NortheastDesigns/Venturi-MK8/IMPORTANT Turnaround differences.jpg

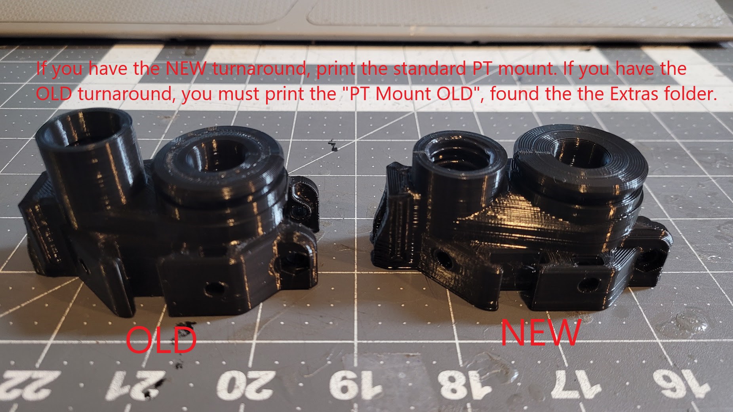
IMPORTANT Turnaround differences.jpg
