NortheastDesigns/Venturi-MK8/Frame Kit Package Contents.pdf

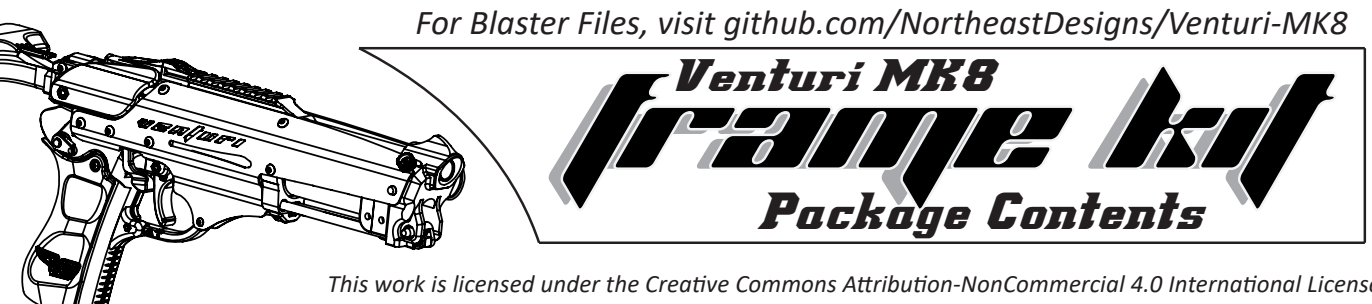
[picture p2: figure]
Venturi MK8; Package Contents; For Blaster Files, visit github.com/NortheastDesigns/Venturi-MK8 Frame kit frame kit

This work is licensed under the Creative Commons Attribution-NonCommercial 4.0 International License. To view a copy of this license, visit http://creativecommons.org/licenses/by-nc/4.0/

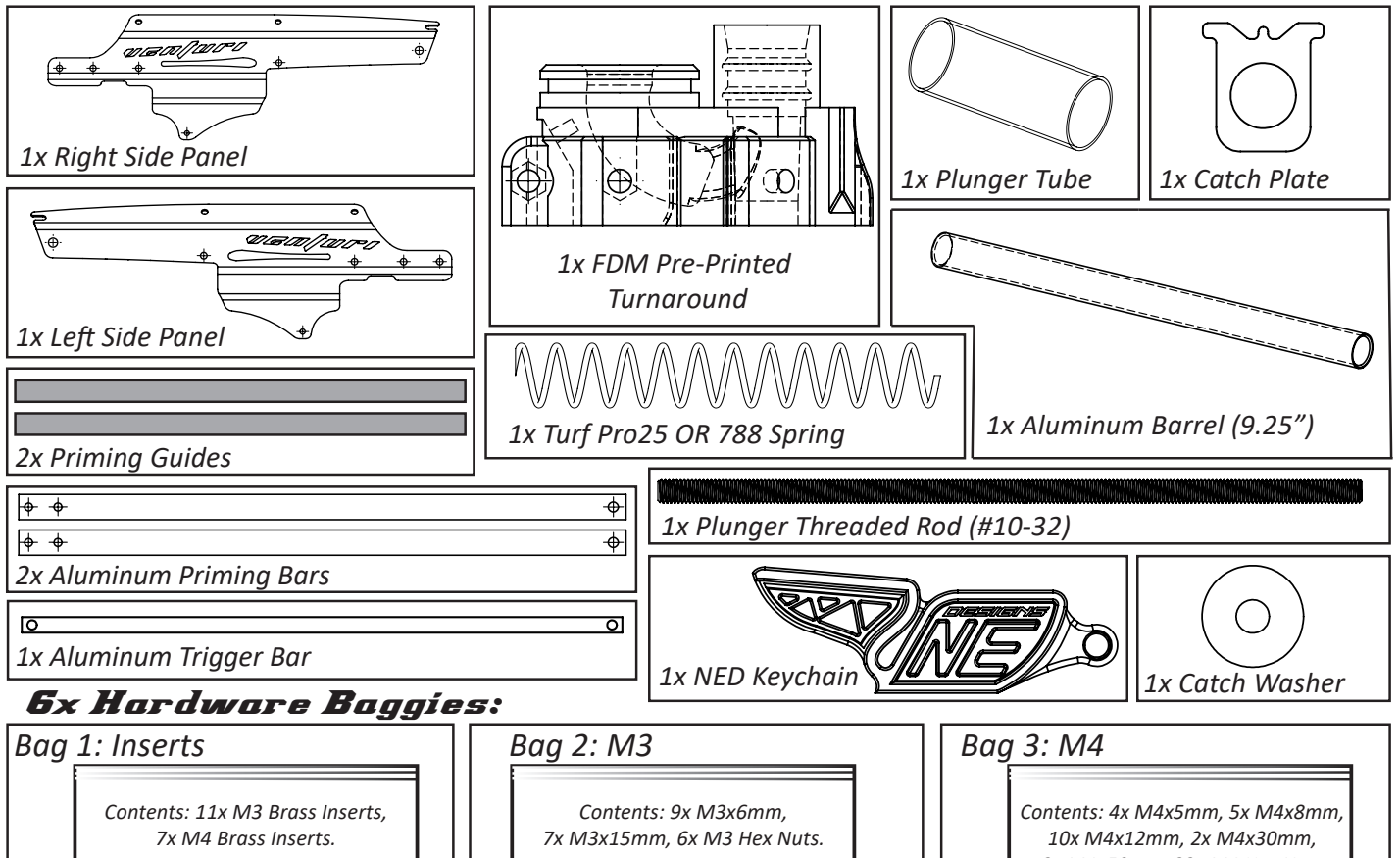
[picture p3: figure]
6x Hardware Baggies:; Lorem ipsum; 1x Aluminum Barrel (9.25”); 1x Plunger Tube; 1x Catch Plate; 1x FDM Pre-Printed Turnaround; 1x Turf Pro25 OR 788 Spring; 1x Plunger Threaded Rod (#10-32); 1x Right Side Panel; 1x Left Side Panel; Bag 1: Inserts; Bag 2: M3; Bag 3: M4; 2x Priming Guides; 2x Aluminum Priming Bars; Contents: 9x M3x6mm, 7x M3x15mm, 6x M3 Hex Nuts.; Contents: 4x M4x5mm, 5x M4x8mm, 10x M4x12mm, 2x M4x30mm,; Contents: 11x M3 Brass Inserts, 7x M4 Brass Inserts.; 1x NED Keychain; 1x Catch Washer; 1x Aluminum Trigger Bar

Bag 4: M5 | Bag 5: O Rings | Bag 6: Other 2x M4x50mm, 22x M4 Hex Nuts.

Contents: 3x M5x55mm,
2x M5 Hex Nuts.

Contents: 1x 123 Buna X ring, 1x 123 Buna O ring, 3x 202 Buna O rings.

Contents: 2 x 10-32 Acorn Nut, 3x Small Springs, 1x Body detent pin, 1x Actuator Detent Pin.

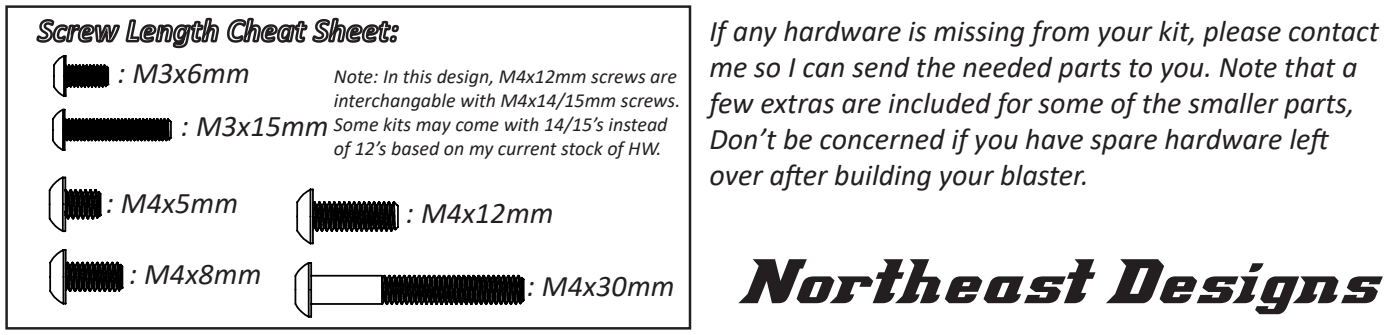
[picture p4: figure]
Northeast Designs; interchangable with M4x14/15mm screws. Some kits may come with 14/15’s instead; over after building your blaster.

Note: In this design, M4x12mm screws are

of 12’s based on my current stock of HW.

If any hardware is missing from your kit, please contact me so I can send the needed parts to you. Note that a few extras are included for some of the smaller parts, Don’t be concerned if you have spare hardware left
