NortheastDesigns/Venturi-MK8/Group A/Group A Orientations.PNG

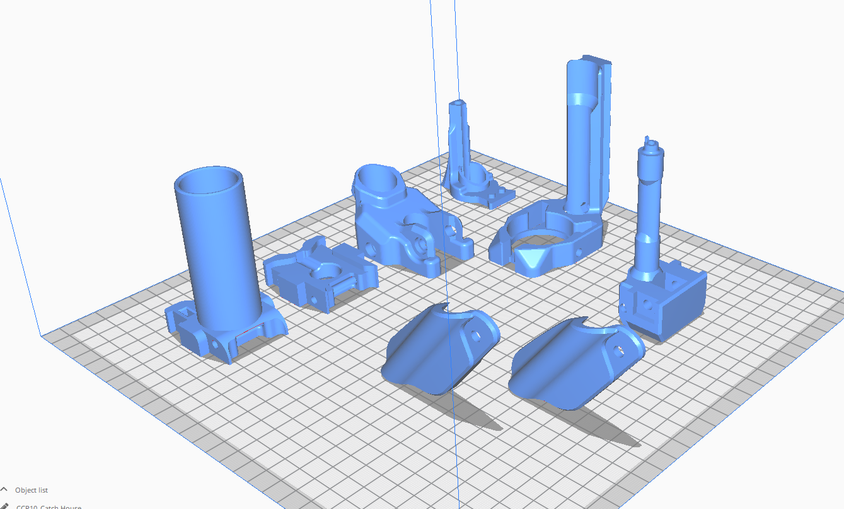
Group A/Group A Orientations.PNG
