NortheastDesigns/Venturi-MK8/Group B/Group B Orientations.PNG

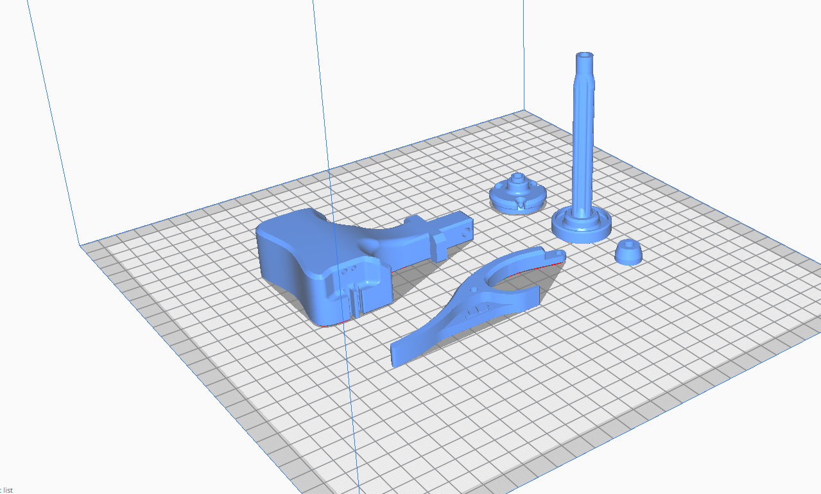
Group B/Group B Orientations.PNG
