NortheastDesigns/Venturi-MK8/Group C/Group C Orientations.PNG

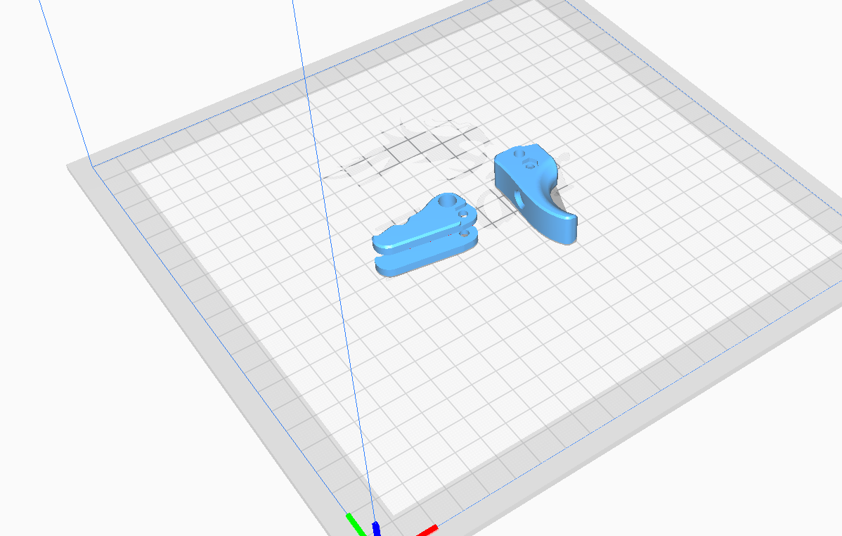
Group C/Group C Orientations.PNG
