NortheastDesigns/Venturi-MK8/Group D/Group D Orientations.PNG

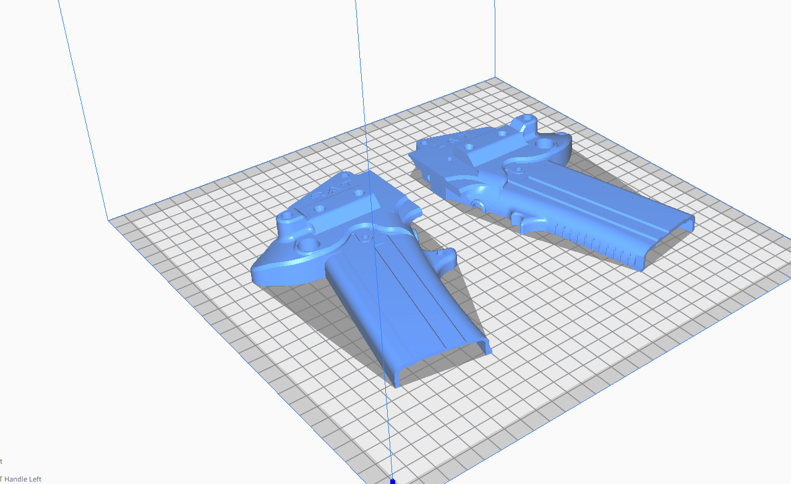
Group D/Group D Orientations.PNG
