NortheastDesigns/Venturi-MK8/Group E/Group E Orientations.PNG

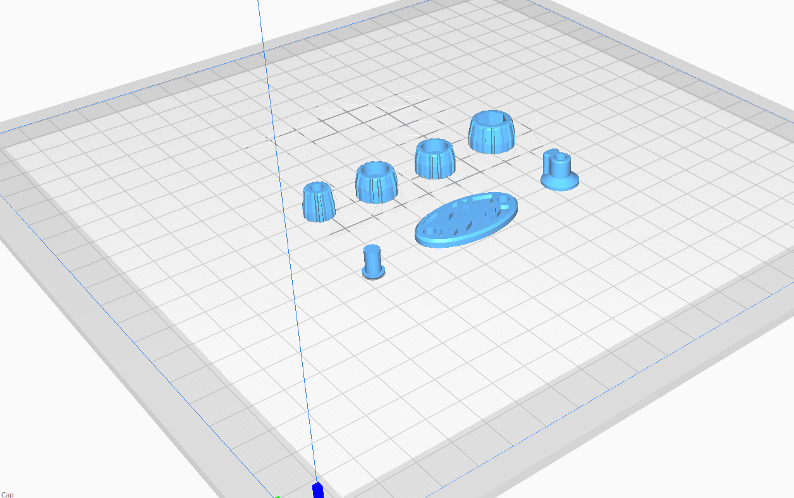
Group E/Group E Orientations.PNG
