NortheastDesigns/Venturi-MK8/Group F/Group F Orientation.PNG

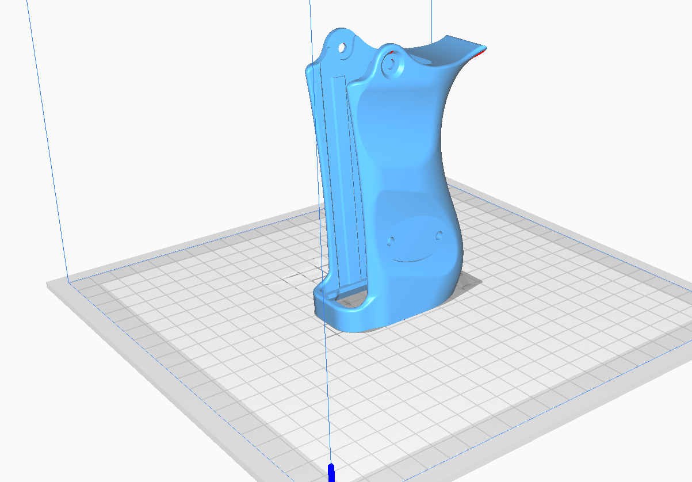
Group F/Group F Orientation.PNG
