NortheastDesigns/Venturi-MK8/Carbine/Finish Plate 1 Carbine.STL

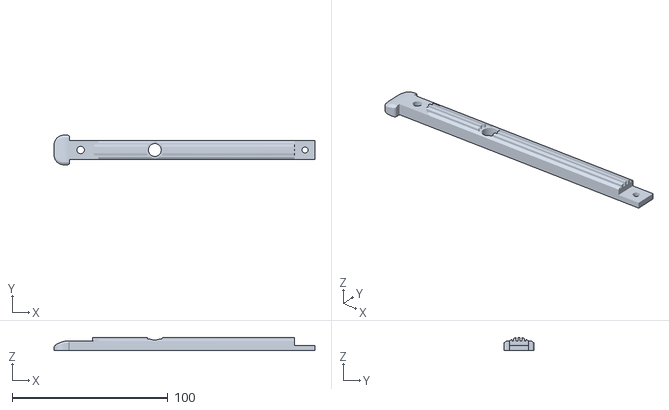
[picture p11: CAD file, 2021-06-01]
Carbine/Finish Plate 1 Carbine.STL
167.6 x 19.1 x 8.57
