NortheastDesigns/Venturi-MK8/Extras and Experimental/Mini T Pull.STL

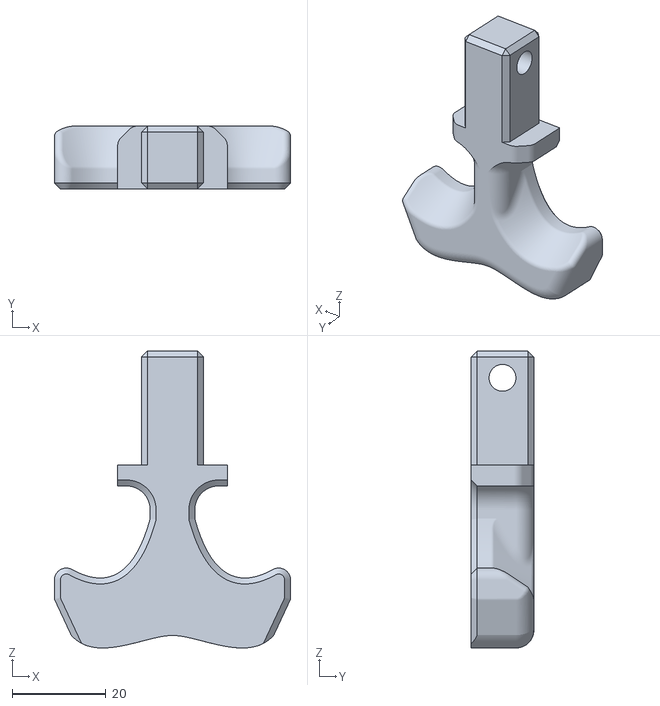
[picture p12: CAD file, 2022-07-08]
Extras and Experimental/Mini T Pull.STL
50.3 x 13.4 x 63.2
