NortheastDesigns/Venturi-MK8/Group A/Pusher.STL

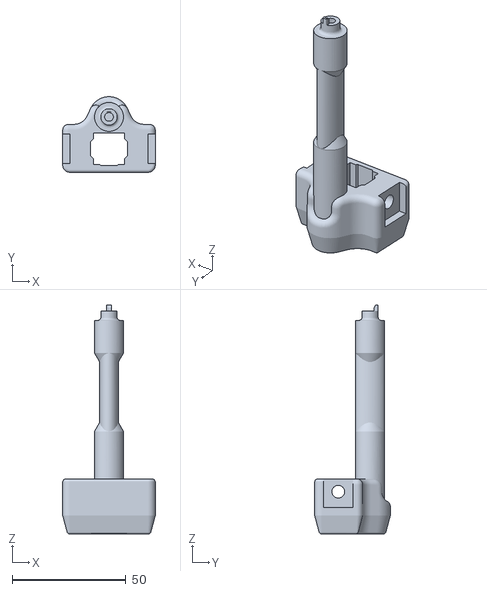
[picture p13: CAD file, 2022-07-08]
Group A/Pusher.STL
40.6 x 33.2 x 100.5
