NortheastDesigns/Venturi-MK8/Group B/T Pull.STL

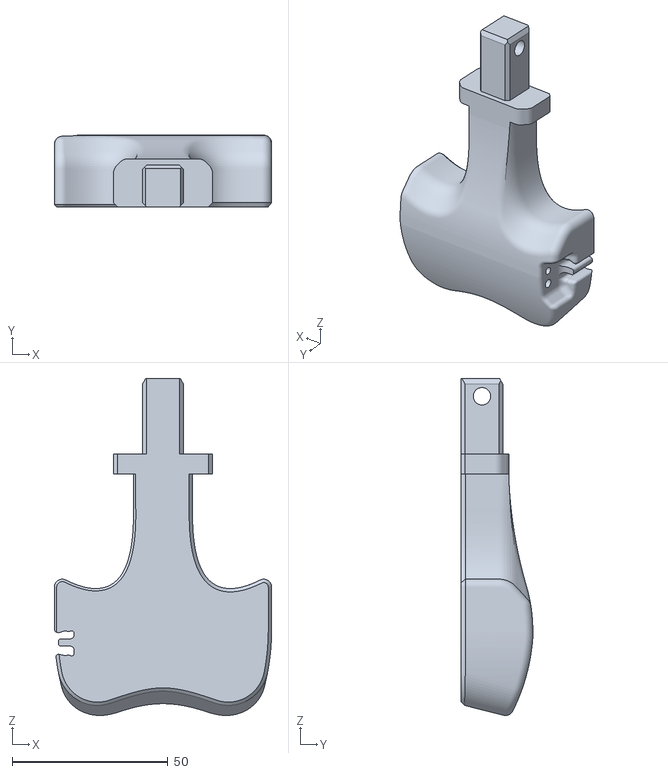
[picture p14: CAD file, 2022-07-08]
Group B/T Pull.STL
69.8 x 23.0 x 108.3
