NortheastDesigns/Venturi-MK8/Group C/Alternate Actuators/Actuator +.0125.STL

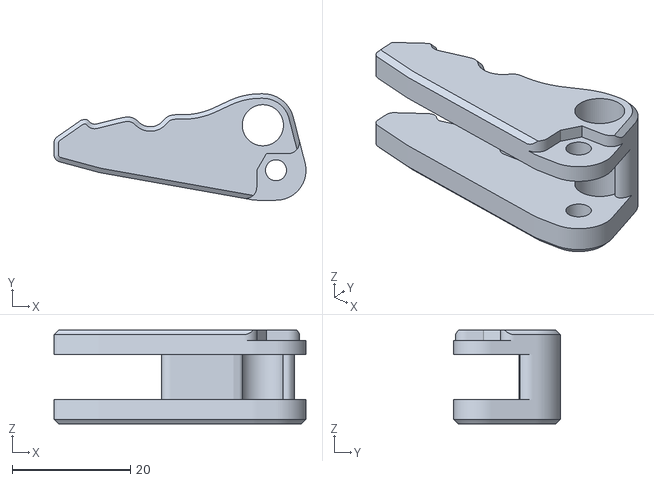
[picture p15: CAD file, 2021-04-18]
Group C/Alternate Actuators/Actuator +.0125.STL
42.7 x 18.0 x 15.9
