NortheastDesigns/Venturi-MK8/Group C/Trigger.STL

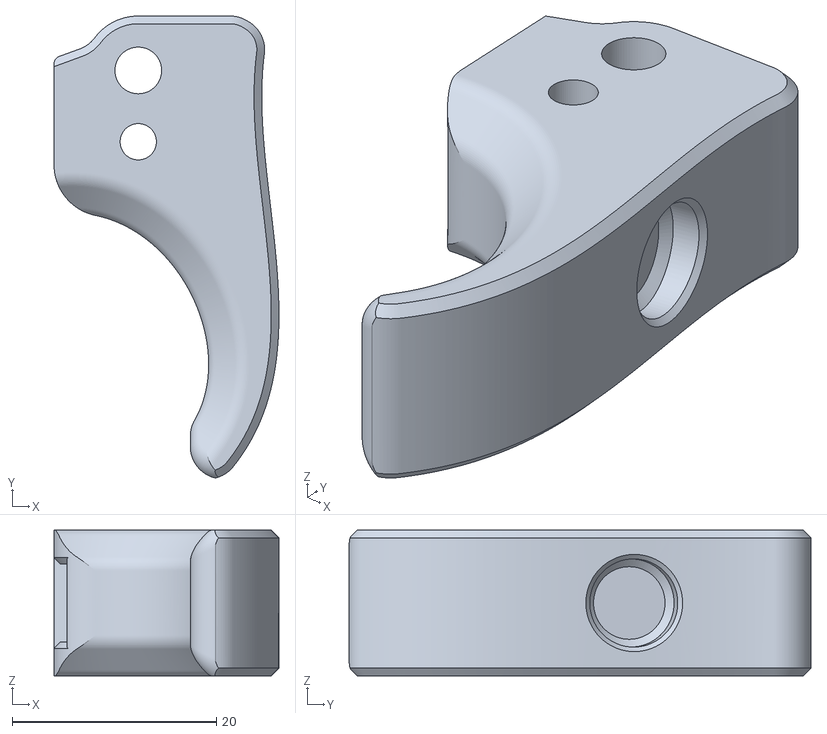
[picture p16: CAD file, 2021-08-10]
Group C/Trigger.STL
22.0 x 45.3 x 14.3
