NortheastDesigns/Venturi-MK8/Group D/ST Handle Right.STL

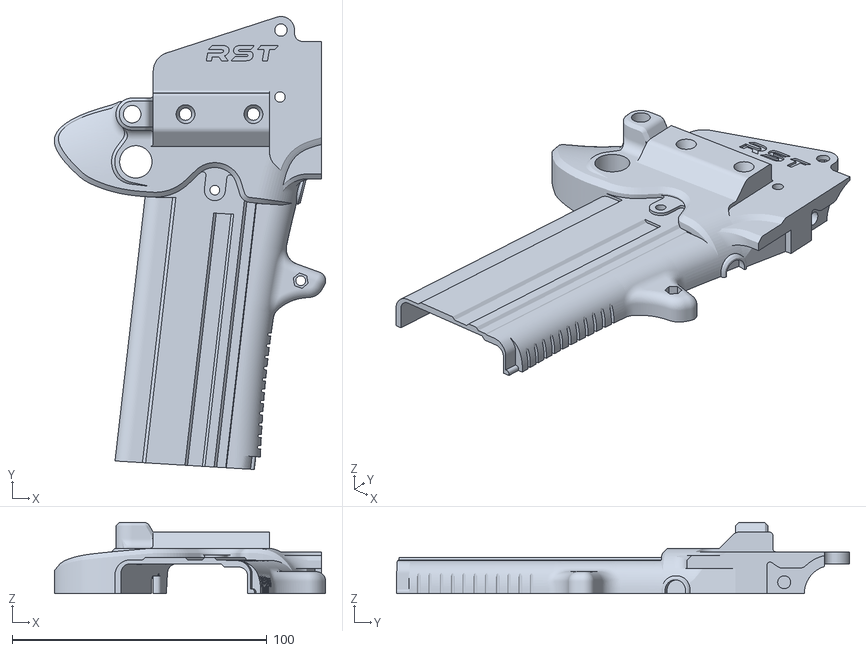
[picture p17: CAD file, 2021-05-18]
Group D/ST Handle Right.STL
106.6 x 177.9 x 27.9
