NortheastDesigns/Venturi-MK8/NO INSERTS/NO INSERTS ST Handle Left.STL

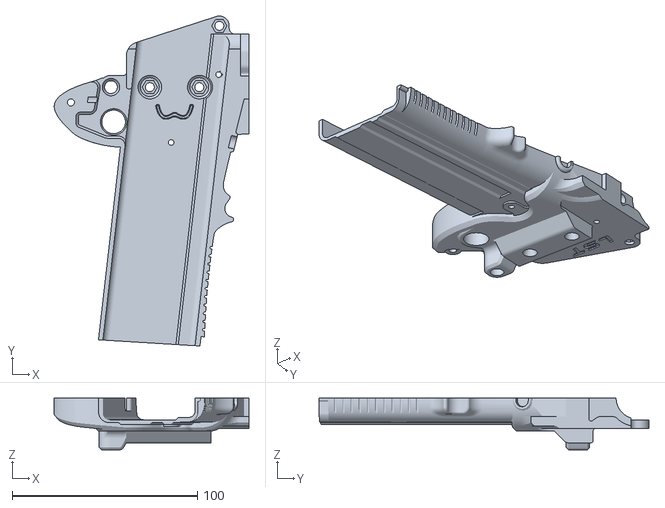
[picture p18: CAD file, 2021-04-18]
NO INSERTS/NO INSERTS ST Handle Left.STL
104.9 x 177.9 x 27.9
