NortheastDesigns/Venturi-MK8/Slim AT Handle/NO BOTTOM SHIM SLIM AT Handle Left.STL

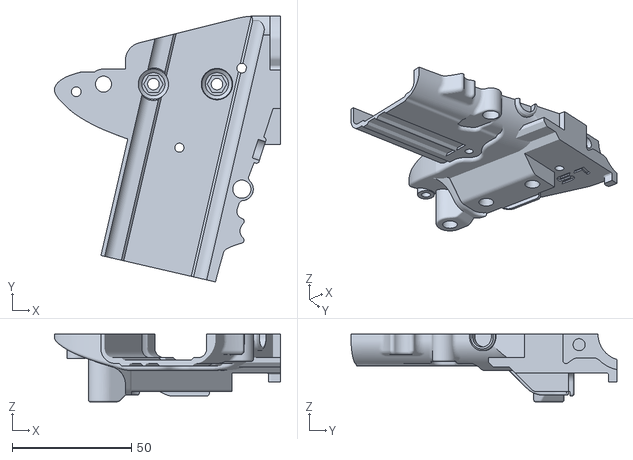
[picture p19: CAD file, 2022-07-27]
Slim AT Handle/NO BOTTOM SHIM SLIM AT Handle Left.STL
94.9 x 111.6 x 28.4
