NortheastDesigns/Venturi-MK8/Slimnose/Alternate Actuators/Slimnose Actuator +.025.STL

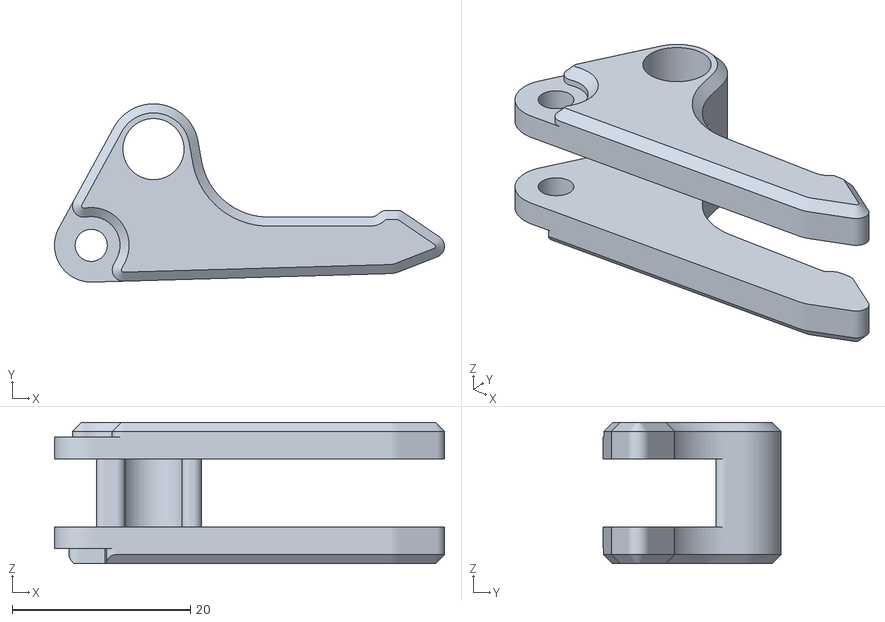
[picture p20: CAD file, 2022-07-08]
Slimnose/Alternate Actuators/Slimnose Actuator +.025.STL
43.8 x 20.0 x 15.9
