NortheastDesigns/Venturi-MK8/vertGrip_v2/vertGrip_rear_v2.stl

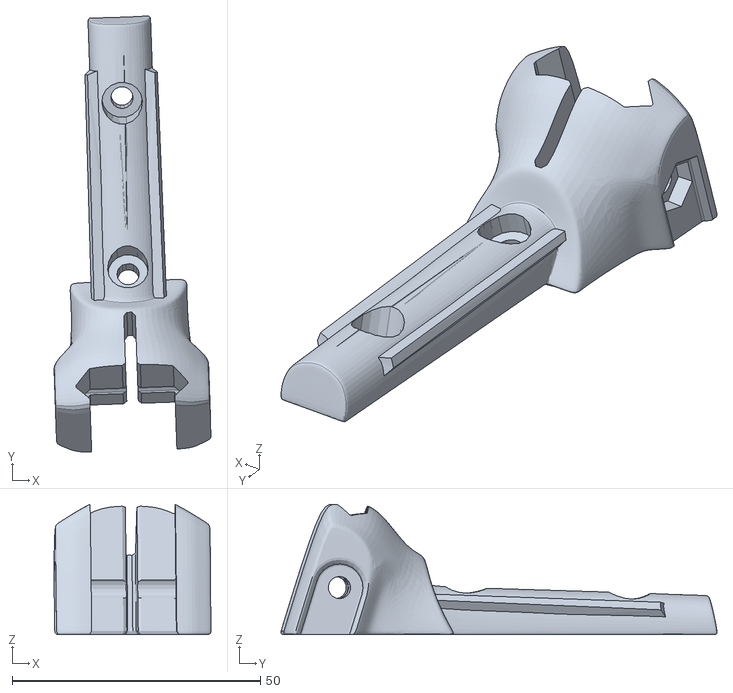
[picture p21: CAD file, 2022-07-27]
vertGrip_v2/vertGrip_rear_v2.stl
31.6 x 87.8 x 26.2
