NortheastDesigns/Venturi-MK8/Carbine/Finish Plate 2 Carbine.STL

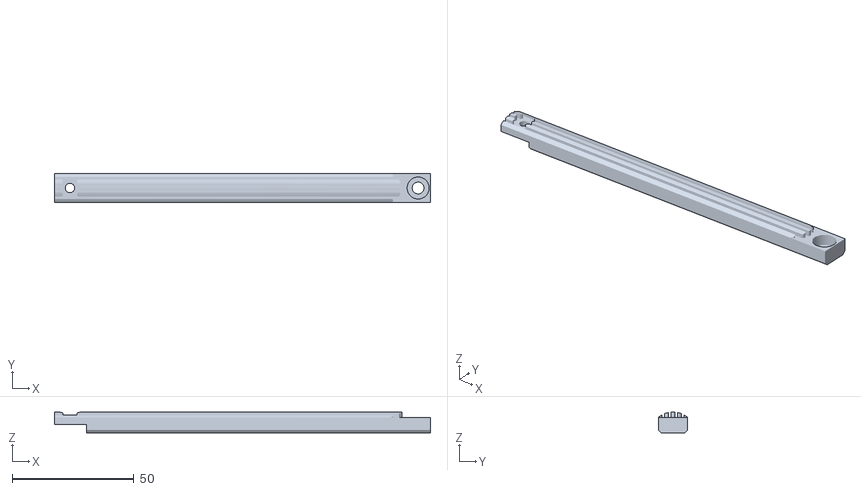
[picture p22: CAD file, 2021-06-01]
Carbine/Finish Plate 2 Carbine.STL
154.2 x 12.1 x 8.57
