NortheastDesigns/Venturi-MK8/Extras and Experimental/Pusher Adjustable Seal.STL

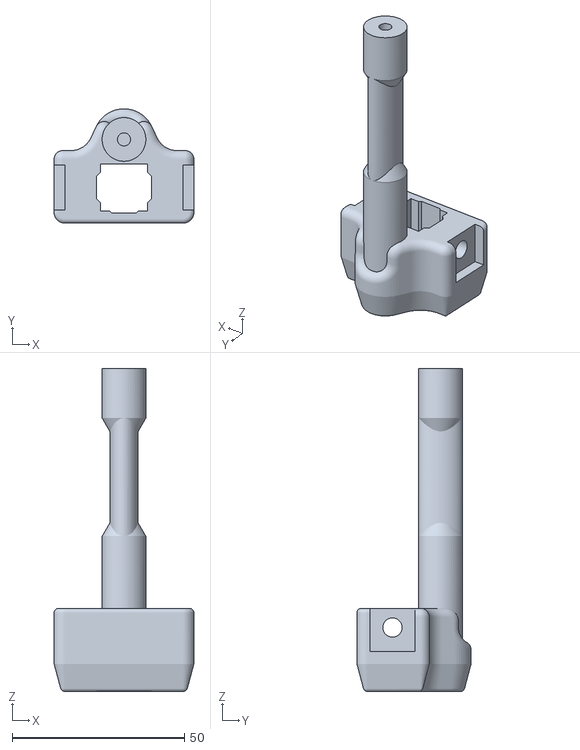
[picture p23: CAD file, 2022-07-08]
Extras and Experimental/Pusher Adjustable Seal.STL
40.6 x 33.2 x 93.8
