NortheastDesigns/Venturi-MK8/Group A/R Slide.STL

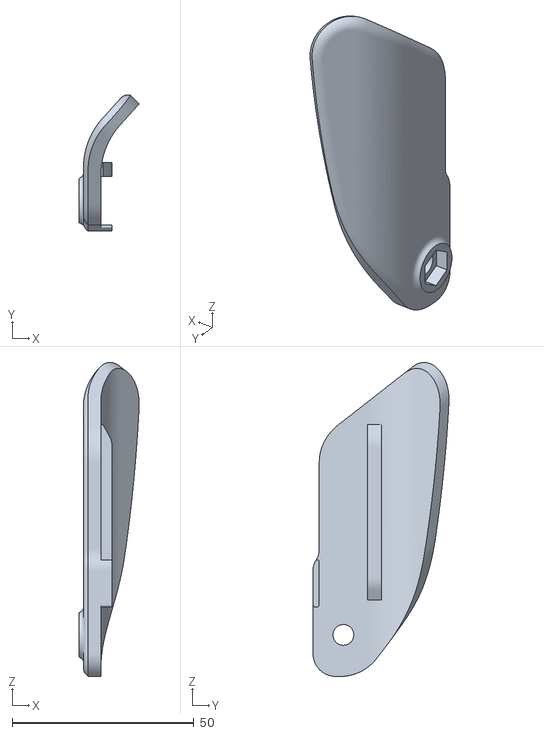
[picture p24: CAD file, 2022-07-08]
Group A/R Slide.STL
16.6 x 37.4 x 86.3
