NortheastDesigns/Venturi-MK8/Group B/HIGH ENGAGEMENT Plunger.STL

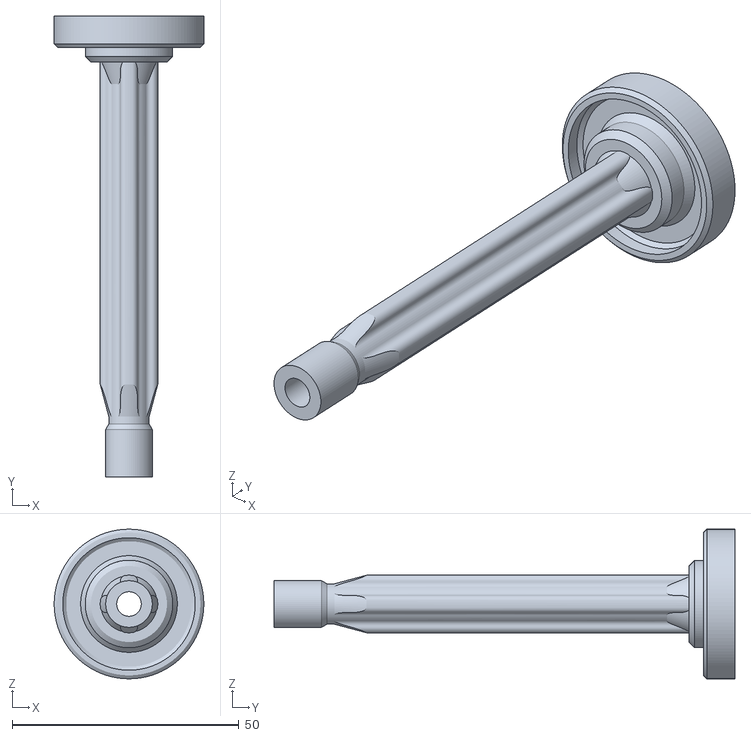
[picture p25: CAD file, 2022-07-08]
Group B/HIGH ENGAGEMENT Plunger.STL
33.0 x 101.7 x 33.0
