NortheastDesigns/Venturi-MK8/Group C/Actuator.STL

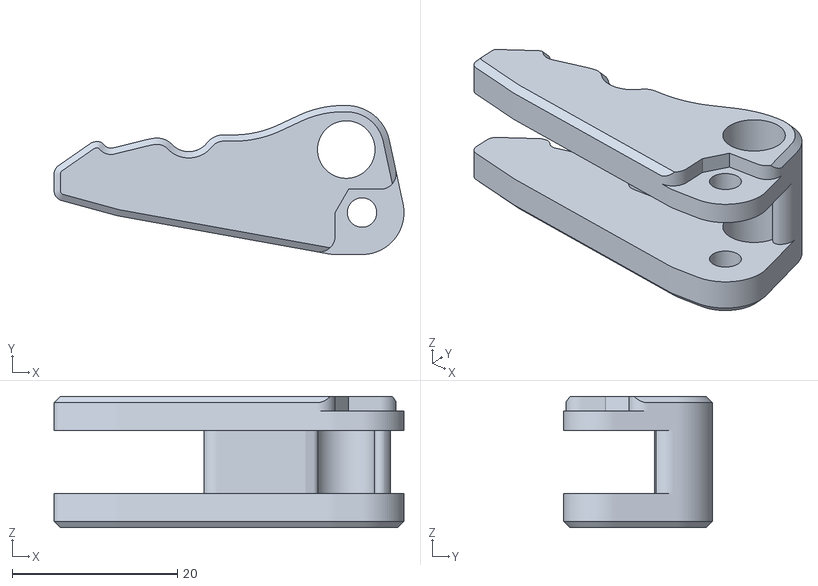
[picture p26: CAD file, 2021-04-18]
Group C/Actuator.STL
42.3 x 18.0 x 15.9
