NortheastDesigns/Venturi-MK8/Group C/Alternate Actuators/Actuator +.0625.STL

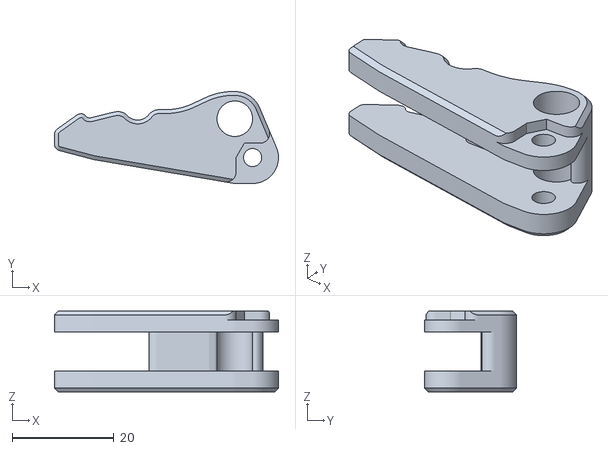
[picture p27: CAD file, 2021-04-18]
Group C/Alternate Actuators/Actuator +.0625.STL
43.9 x 18.0 x 15.9
