NortheastDesigns/Venturi-MK8/Slim AT Handle/SLIM AT Handle Right.STL

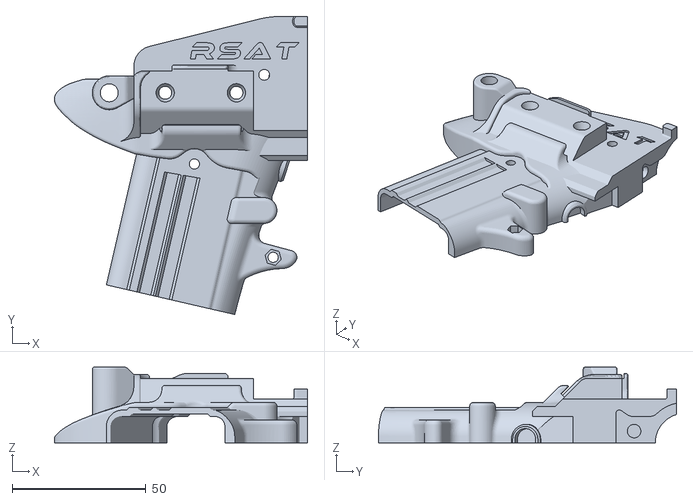
[picture p28: CAD file, 2022-07-27]
Slim AT Handle/SLIM AT Handle Right.STL
94.9 x 111.6 x 28.4
