NortheastDesigns/Venturi-MK8/Slimnose/Slimnose Muzzle.STL

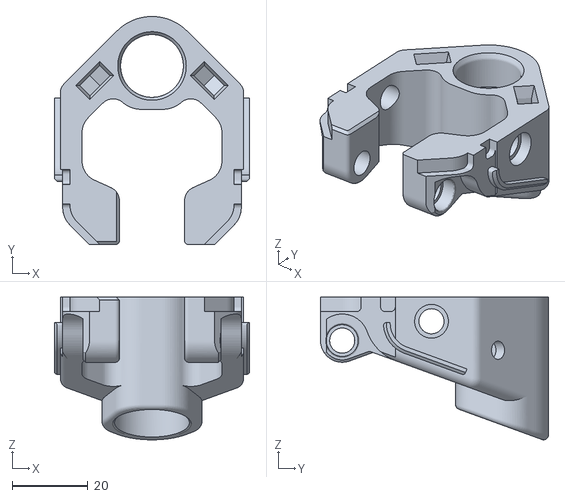
[picture p29: CAD file, 2022-07-08]
Slimnose/Slimnose Muzzle.STL
51.4 x 60.0 x 37.6
