NortheastDesigns/Venturi-MK8/Carbine/Pump Mount.STL

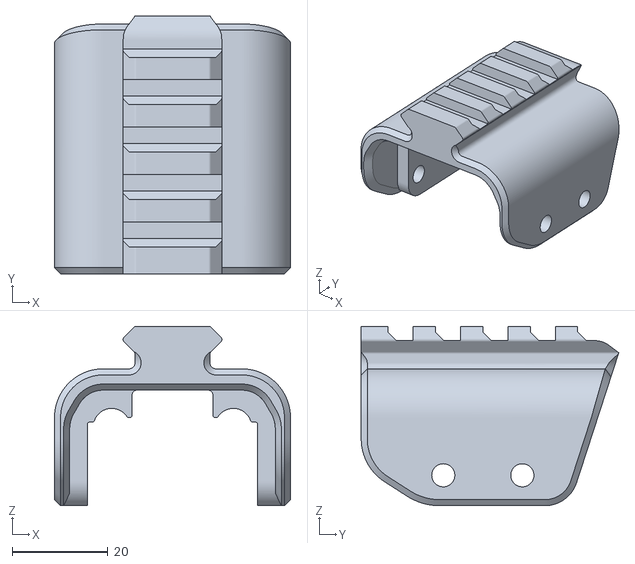
[picture p30: CAD file, 2021-06-01]
Carbine/Pump Mount.STL
49.3 x 53.8 x 37.5
