NortheastDesigns/Venturi-MK8/Extras and Experimental/Pusher Seat Min.STL

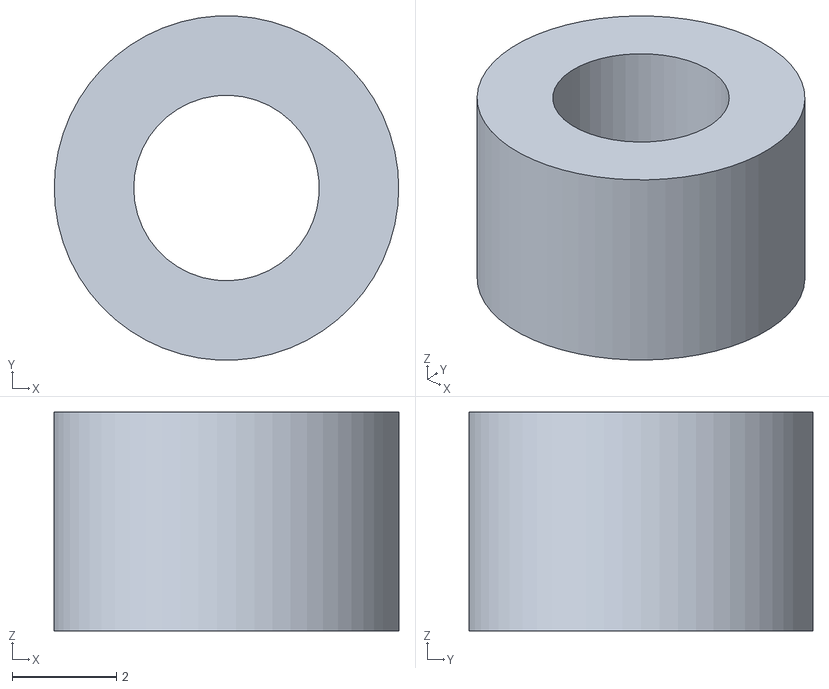
[picture p31: CAD file, 2022-07-08]
Extras and Experimental/Pusher Seat Min.STL
6.60 x 6.59 x 4.19
