NortheastDesigns/Venturi-MK8/Group A/L Slide.STL

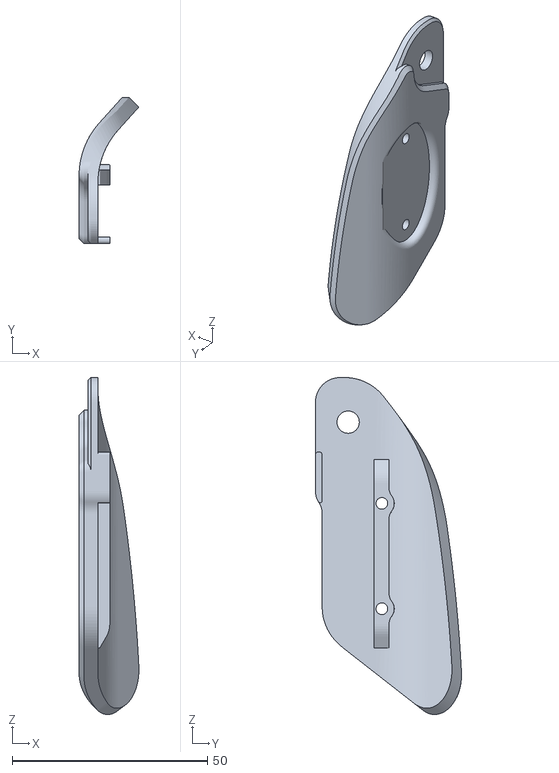
[picture p32: CAD file, 2022-07-08]
Group A/L Slide.STL
15.3 x 37.4 x 86.3
