NortheastDesigns/Venturi-MK8/Group B/LOW ENGAGEMENT Plunger.STL

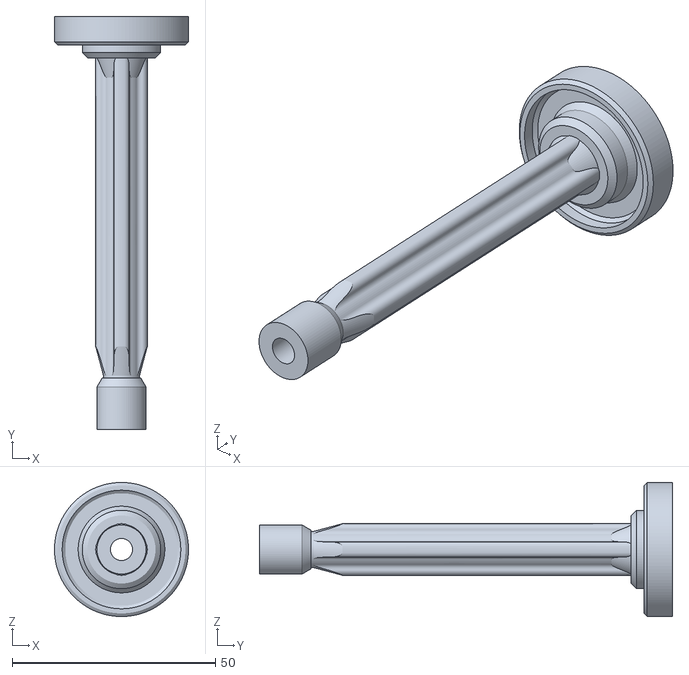
[picture p33: CAD file, 2022-07-08]
Group B/LOW ENGAGEMENT Plunger.STL
33.0 x 101.7 x 33.0
