NortheastDesigns/Venturi-MK8/Group C/Alternate Actuators/Actuator +.0375.STL

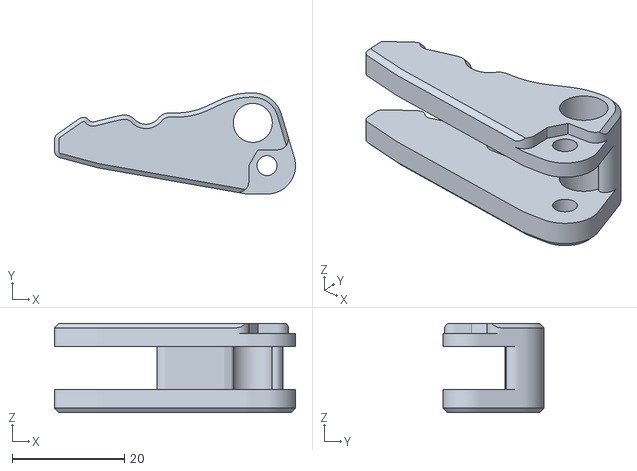
[picture p34: CAD file, 2021-04-18]
Group C/Alternate Actuators/Actuator +.0375.STL
43.0 x 18.0 x 15.9
