NortheastDesigns/Venturi-MK8/NO INSERTS/NO INSERTS Pusher.STL

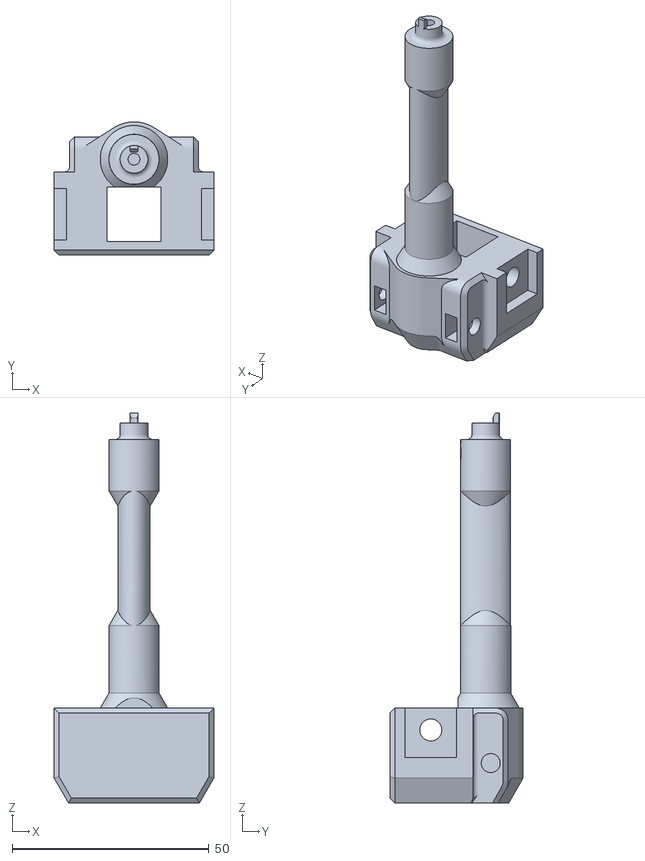
[picture p35: CAD file, 2021-04-18]
NO INSERTS/NO INSERTS Pusher.STL
40.6 x 33.9 x 99.2
