NortheastDesigns/Venturi-MK8/Slimnose/Slimnose Foregrip.STL

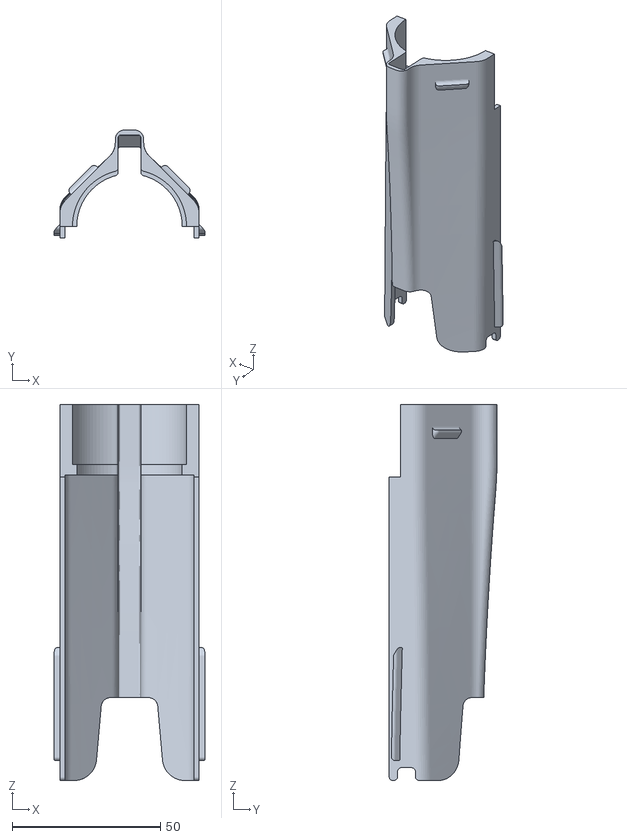
[picture p36: CAD file, 2022-07-08]
Slimnose/Slimnose Foregrip.STL
50.8 x 36.5 x 126.7
