NortheastDesigns/Venturi-MK8/Carbine/Pivot Bushing Carbine.STL

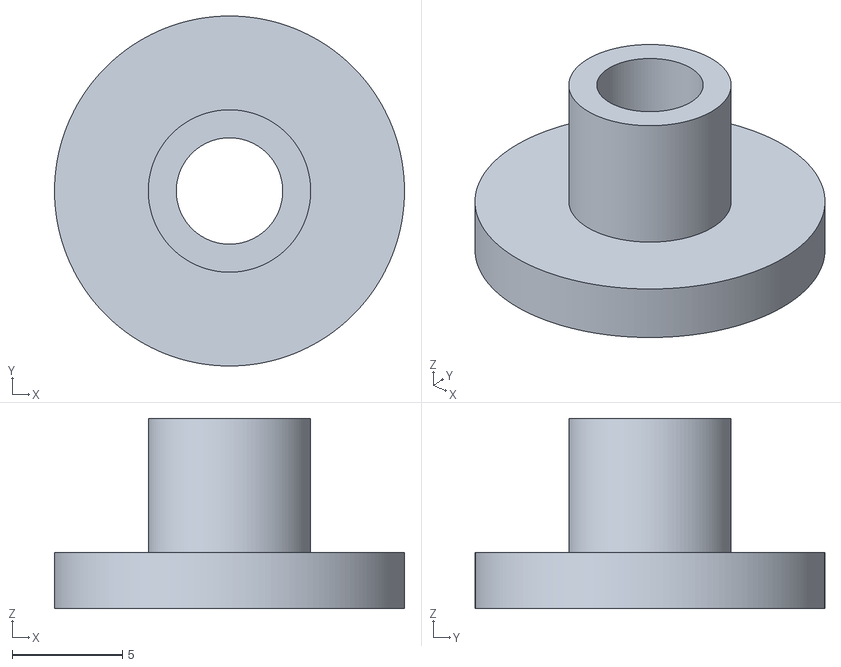
[picture p37: CAD file, 2021-05-07]
Carbine/Pivot Bushing Carbine.STL
15.9 x 15.9 x 8.64
