NortheastDesigns/Venturi-MK8/Extras and Experimental/Pusher Seat Mid.STL

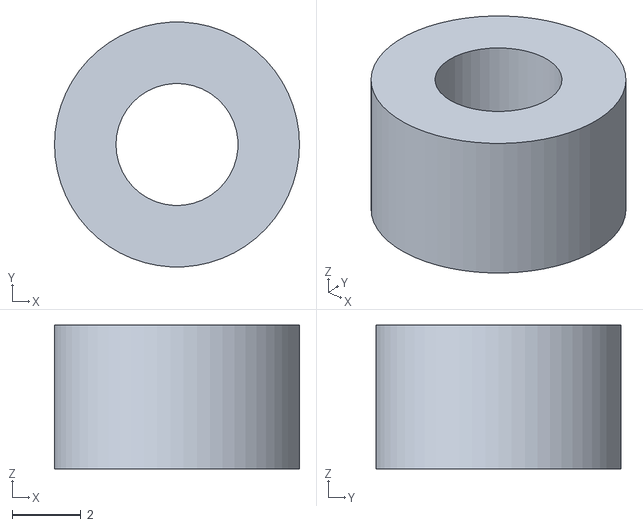
[picture p38: CAD file, 2022-07-08]
Extras and Experimental/Pusher Seat Mid.STL
7.14 x 7.13 x 4.19
