NortheastDesigns/Venturi-MK8/Group A/Muzzle.STL

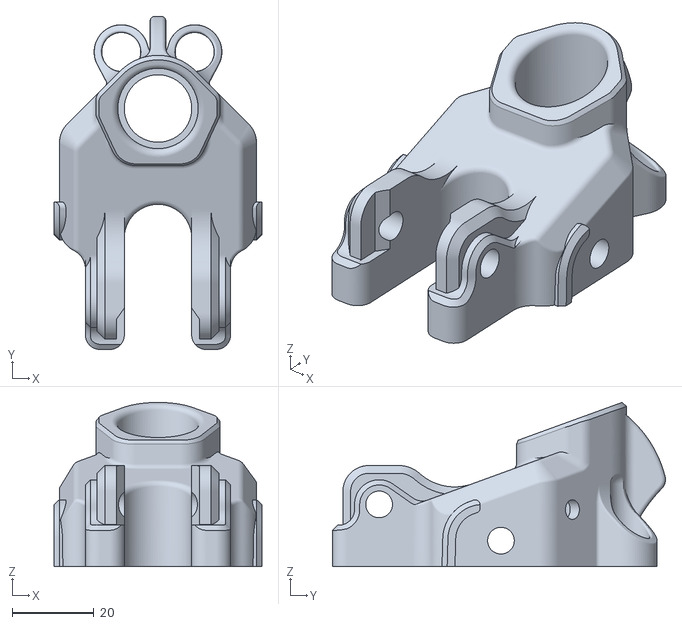
[picture p39: CAD file, 2021-08-10]
Group A/Muzzle.STL
50.9 x 81.6 x 40.2
