NortheastDesigns/Venturi-MK8/Group B/Catch Surface.STL

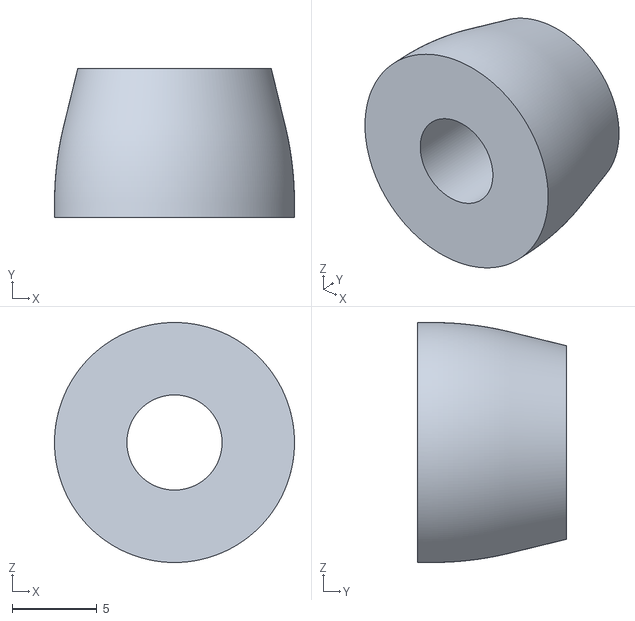
[picture p40: CAD file, 2021-05-18]
Group B/Catch Surface.STL
14.2 x 8.76 x 14.2
