NortheastDesigns/Venturi-MK8/Group E/Pusher Top.STL

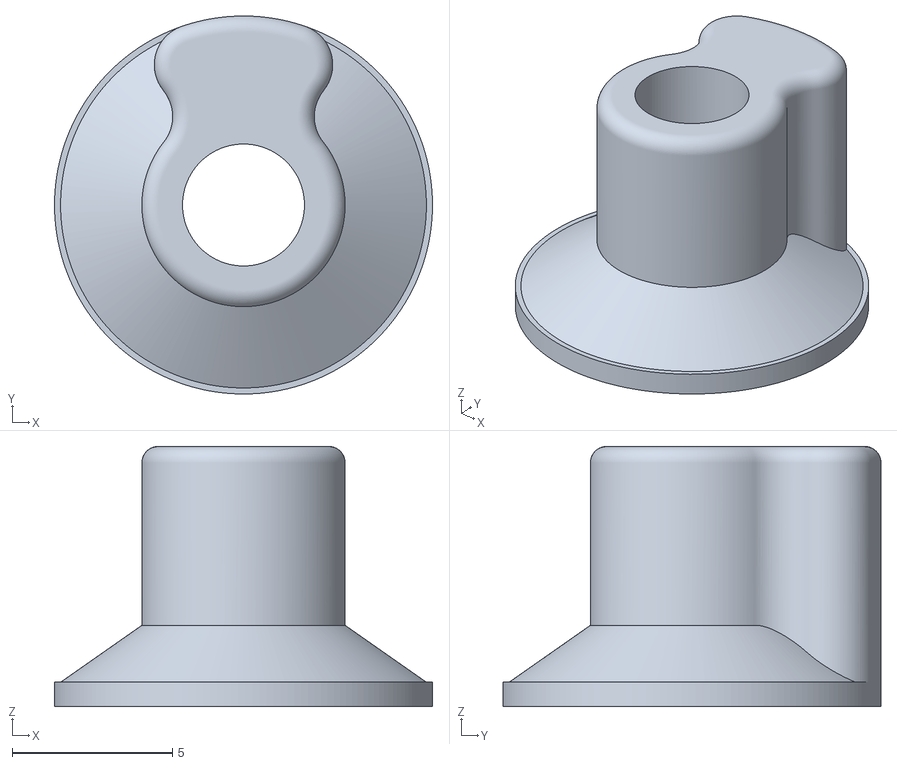
[picture p41: CAD file, 2021-06-01]
Group E/Pusher Top.STL
11.8 x 11.8 x 8.13
