NortheastDesigns/Venturi-MK8/Slimnose/Slimnose PT Mount.STL

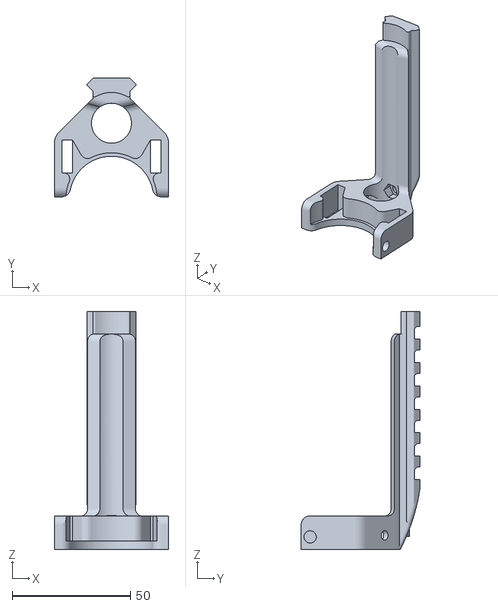
[picture p42: CAD file, 2022-07-08]
Slimnose/Slimnose PT Mount.STL
48.3 x 50.2 x 100.6
