NortheastDesigns/Venturi-MK8/Carbine/Butt Plate Carbine.STL

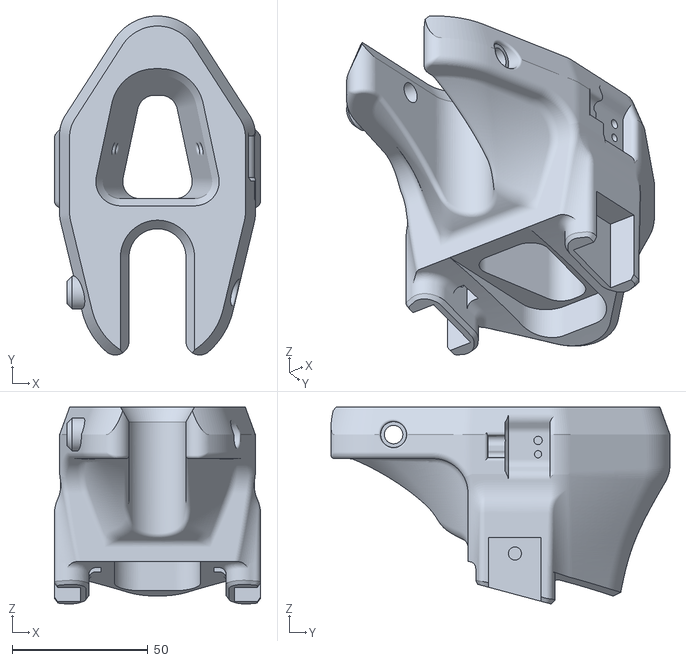
[picture p43: CAD file, 2021-05-07]
Carbine/Butt Plate Carbine.STL
75.9 x 124.9 x 72.6
