NortheastDesigns/Venturi-MK8/Extras and Experimental/Pusher Seat Max.STL

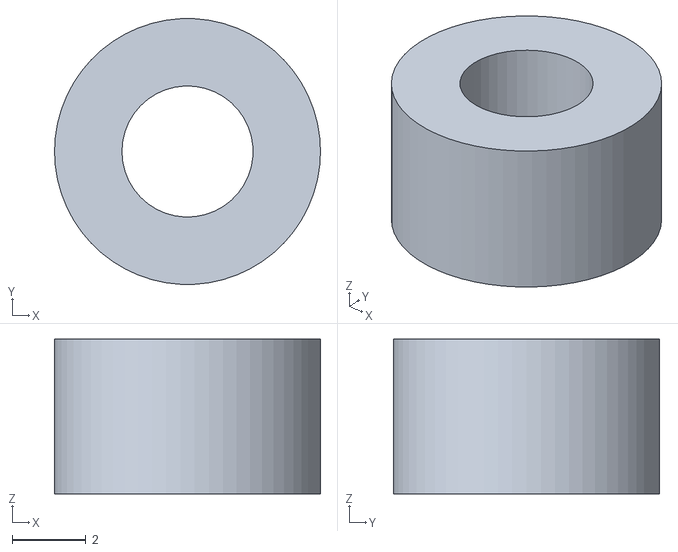
[picture p44: CAD file, 2022-07-08]
Extras and Experimental/Pusher Seat Max.STL
7.21 x 7.20 x 4.19
