NortheastDesigns/Venturi-MK8/Group A/Catch Roof.STL

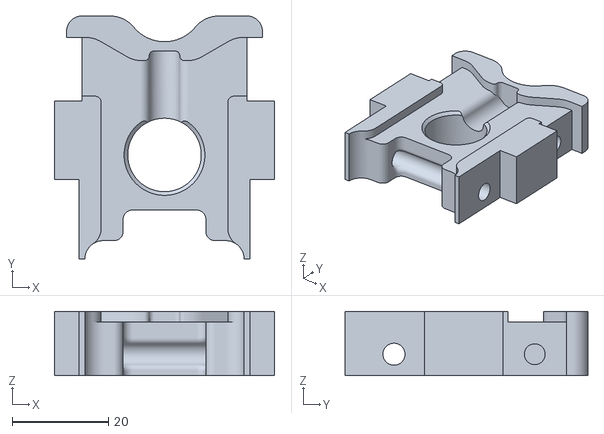
[picture p45: CAD file, 2021-08-10]
Group A/Catch Roof.STL
45.7 x 50.4 x 13.3
