NortheastDesigns/Venturi-MK8/Group B/ST T Gaurd.STL

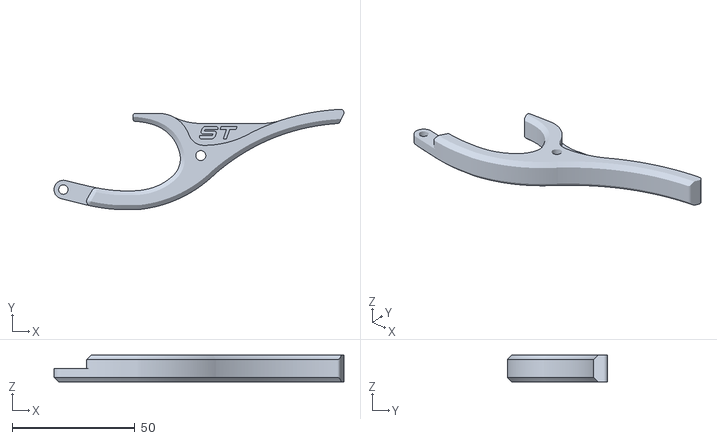
[picture p46: CAD file, 2021-05-18]
Group B/ST T Gaurd.STL
117.9 x 40.7 x 10.9
