NortheastDesigns/Venturi-MK8/NO INSERTS/NO INSERTS AT T Gaurd.STL

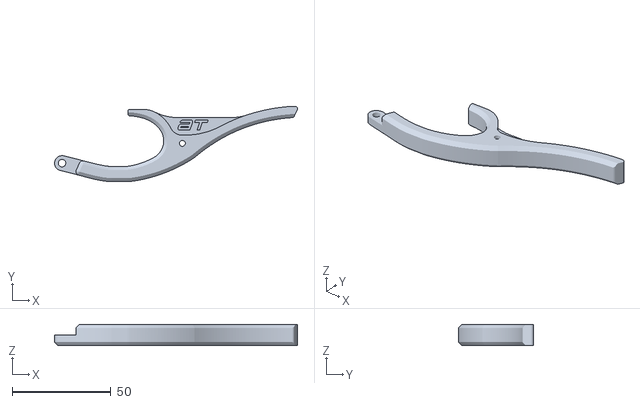
[picture p47: CAD file, 2021-04-11]
NO INSERTS/NO INSERTS AT T Gaurd.STL
122.9 x 38.2 x 10.9
