NortheastDesigns/Venturi-MK8/Slim AT Handle/SLIM AT Release Nub.STL

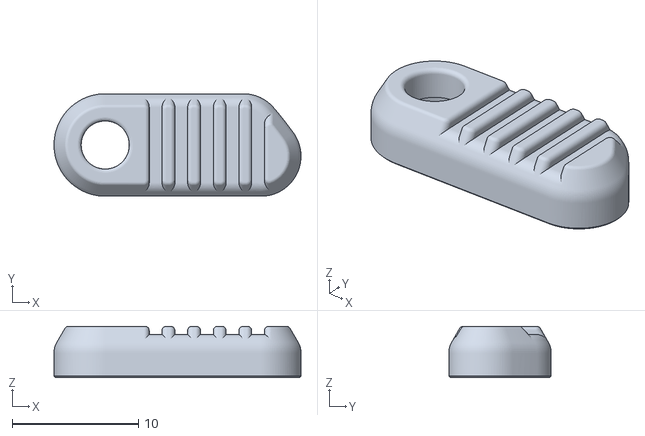
[picture p48: CAD file, 2022-07-08]
Slim AT Handle/SLIM AT Release Nub.STL
19.6 x 8.13 x 4.06
