NortheastDesigns/Venturi-MK8/Slimnose/Slimnose Catch House.STL

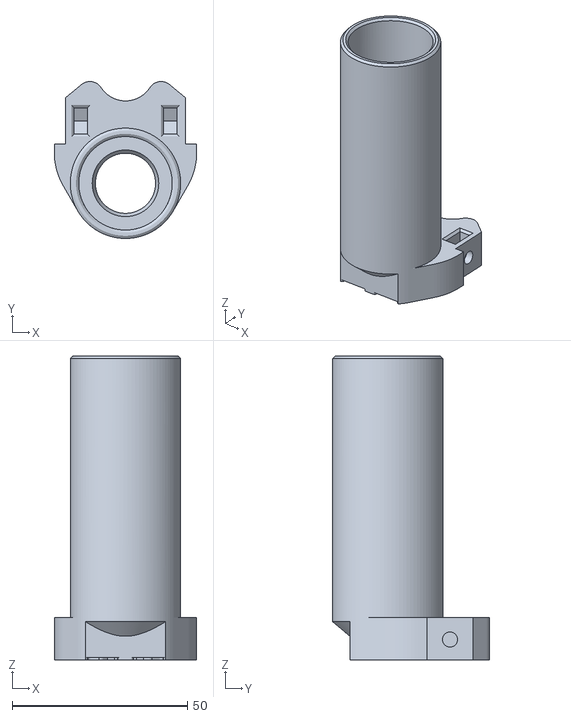
[picture p49: CAD file, 2022-07-08]
Slimnose/Slimnose Catch House.STL
40.6 x 44.8 x 86.7
