NortheastDesigns/Venturi-MK8/Extras and Experimental/Muzzle NO SLING MOUNTS.STL

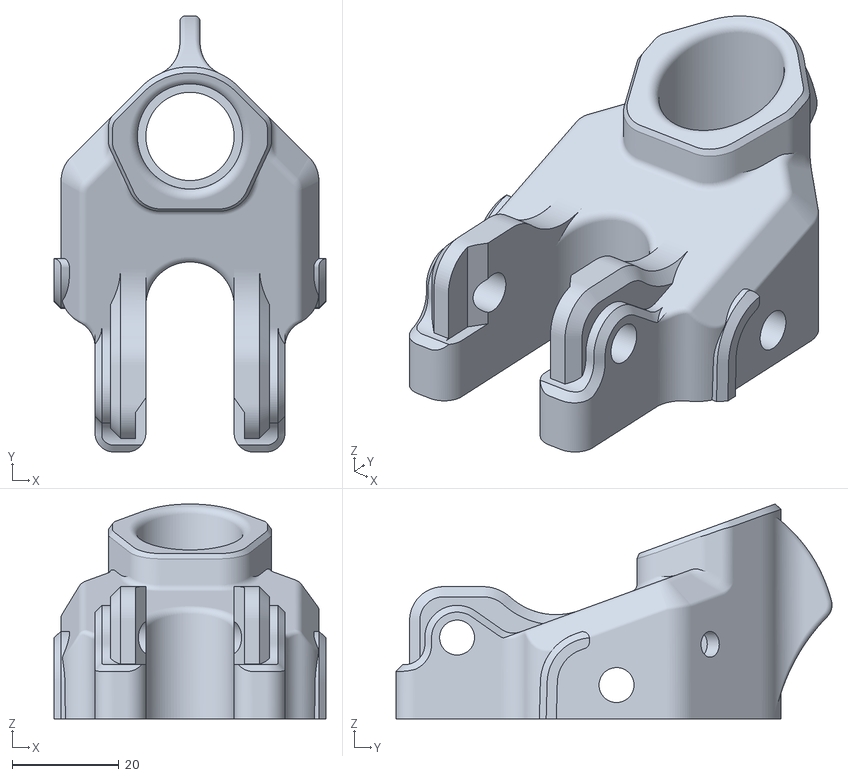
[picture p50: CAD file, 2021-08-14]
Extras and Experimental/Muzzle NO SLING MOUNTS.STL
50.9 x 81.6 x 40.2
