NortheastDesigns/Venturi-MK8/Group A/Dart Tooth.STL

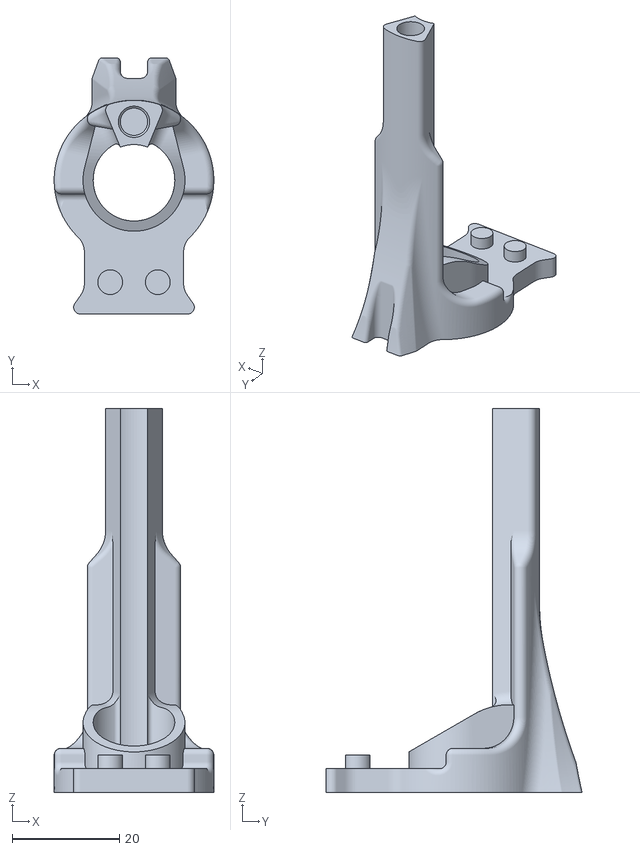
[picture p51: CAD file, 2021-06-01]
Group A/Dart Tooth.STL
29.8 x 47.9 x 71.8
