NortheastDesigns/Venturi-MK8/NO INSERTS/NO INSERTS PT Mount.STL

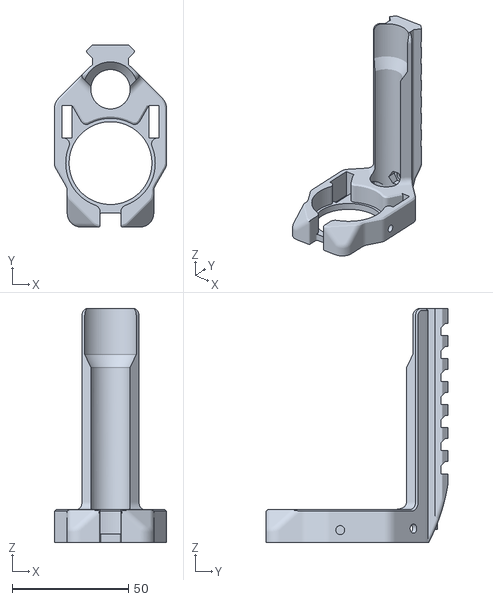
[picture p52: CAD file, 2021-04-11]
NO INSERTS/NO INSERTS PT Mount.STL
48.3 x 78.3 x 100.6
