NortheastDesigns/Venturi-MK8/Slim AT Handle/SLIM AT Release.STL

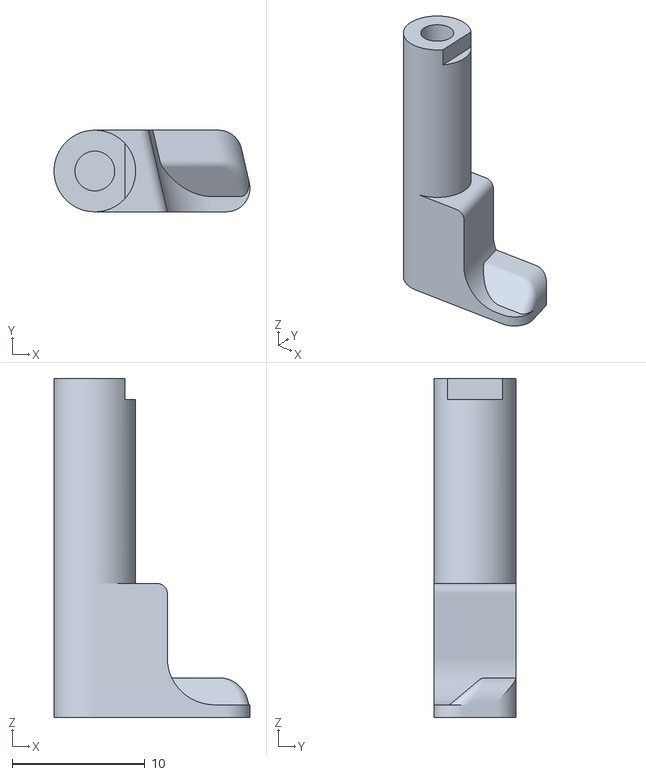
[picture p53: CAD file, 2022-07-08]
Slim AT Handle/SLIM AT Release.STL
14.8 x 6.15 x 25.5
