NortheastDesigns/Venturi-MK8/Slimnose/Slimnose Catch Roof.STL

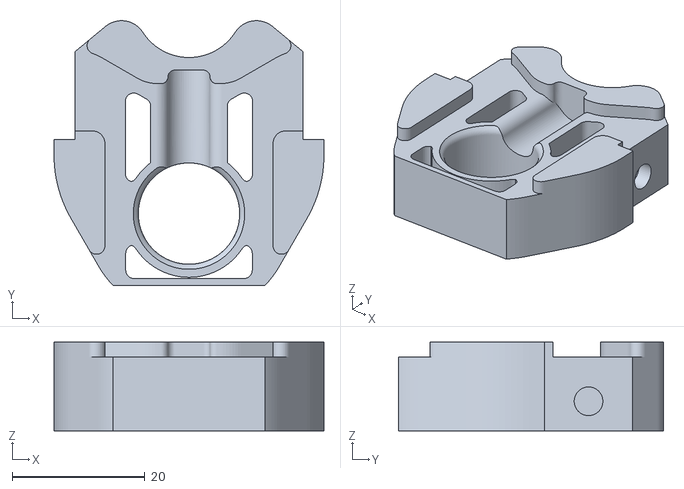
[picture p54: CAD file, 2022-07-08]
Slimnose/Slimnose Catch Roof.STL
40.6 x 39.8 x 13.3
