NortheastDesigns/Venturi-MK8/Extras and Experimental/MonoGrip NO NED LOGO OR SN PLATE.STL

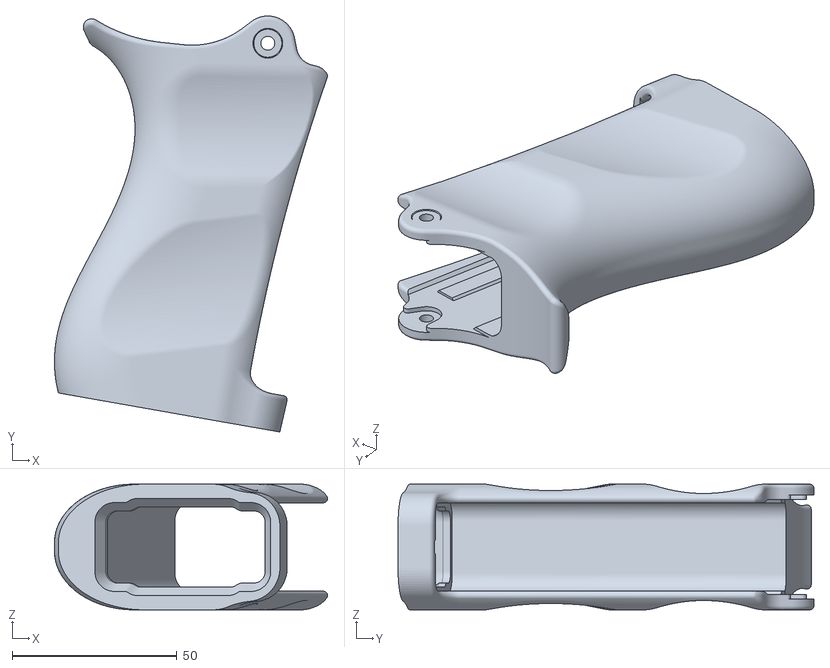
[picture p55: CAD file, 2021-05-18]
Extras and Experimental/MonoGrip NO NED LOGO OR SN PLATE.STL
82.8 x 126.1 x 38.1
