NortheastDesigns/Venturi-MK8/Group A/Release External.STL

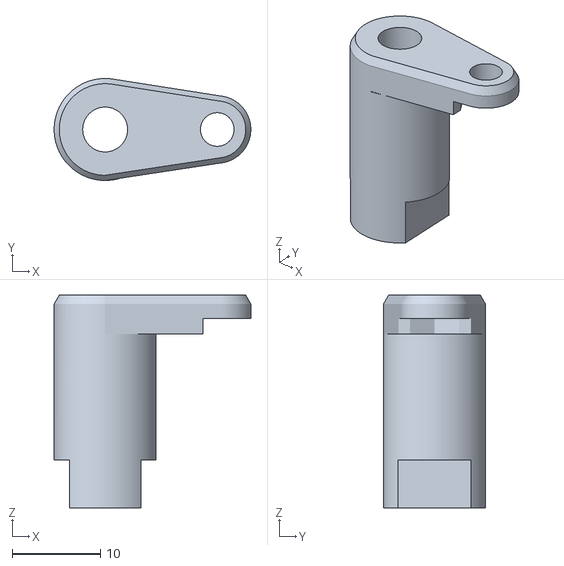
[picture p56: CAD file, 2021-05-18]
Group A/Release External.STL
22.3 x 11.6 x 24.1
