NortheastDesigns/Venturi-MK8/Group E/Dummy Cap.STL

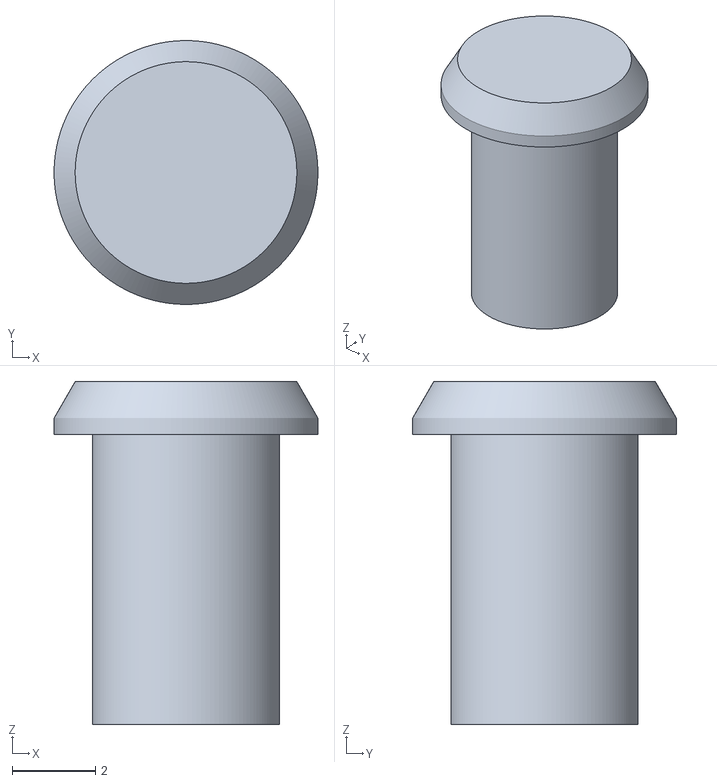
[picture p57: CAD file, 2021-04-11]
Group E/Dummy Cap.STL
6.35 x 6.35 x 8.26
