NortheastDesigns/Venturi-MK8/Slim AT Handle/SLIM AT MonoGrip.STL

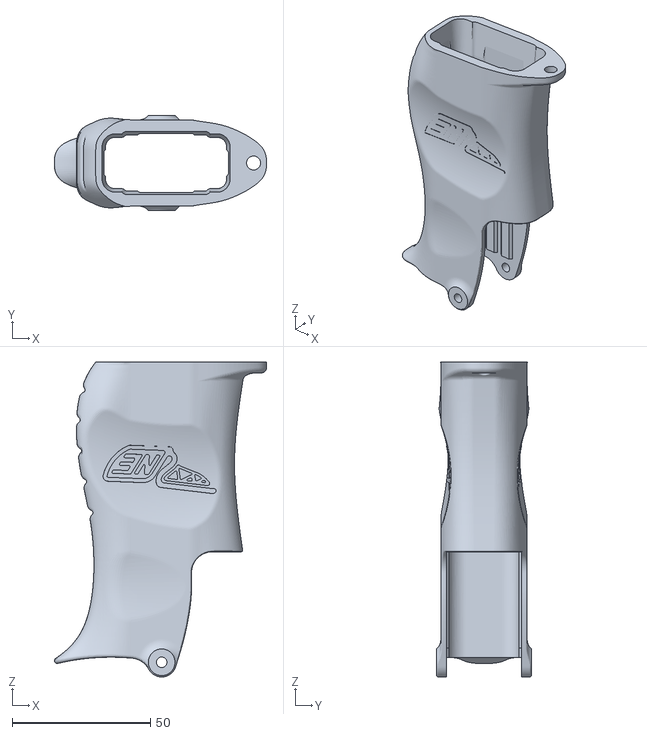
[picture p58: CAD file, 2022-07-08]
Slim AT Handle/SLIM AT MonoGrip.STL
76.8 x 34.4 x 114.0
