NortheastDesigns/Venturi-MK8/Slimnose/Slimnose Actuator.STL

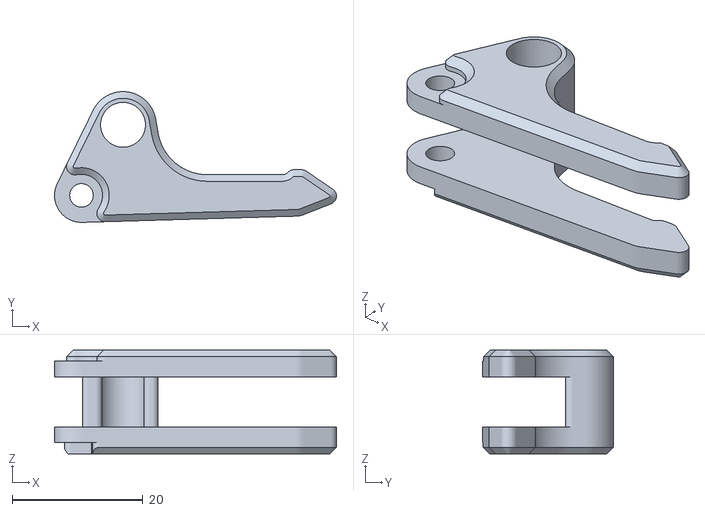
[picture p59: CAD file, 2022-07-08]
Slimnose/Slimnose Actuator.STL
43.1 x 20.0 x 15.9
