NortheastDesigns/Venturi-MK8/Extras and Experimental/Release Nub LONG.STL

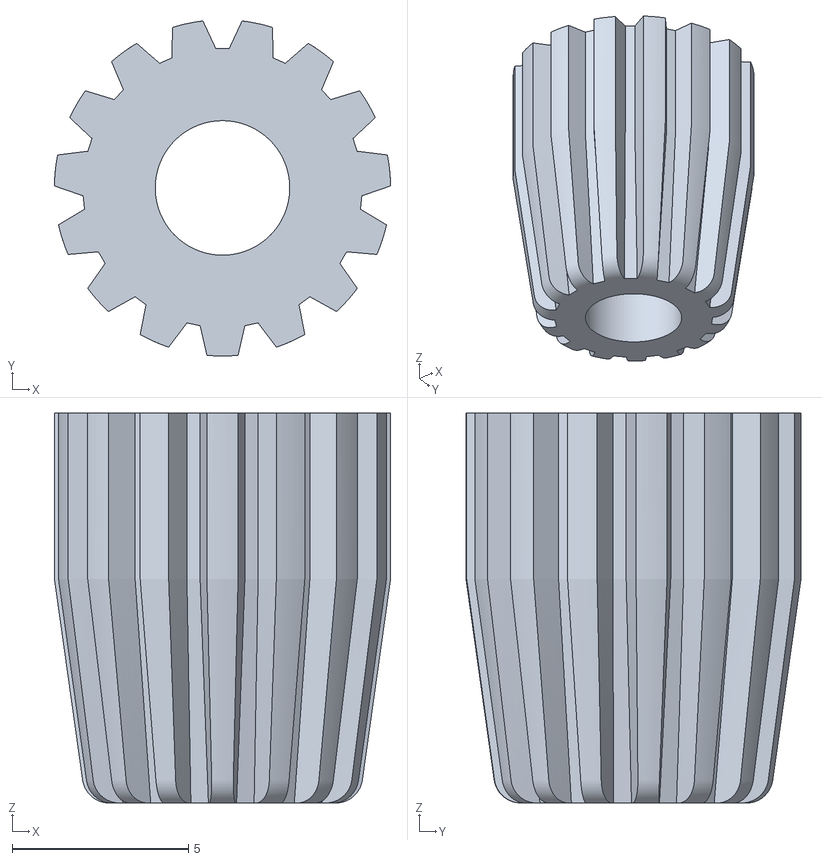
[picture p60: CAD file, 2021-04-24]
Extras and Experimental/Release Nub LONG.STL
9.52 x 9.49 x 11.0
