NortheastDesigns/Venturi-MK8/Group A/Release Internal.STL

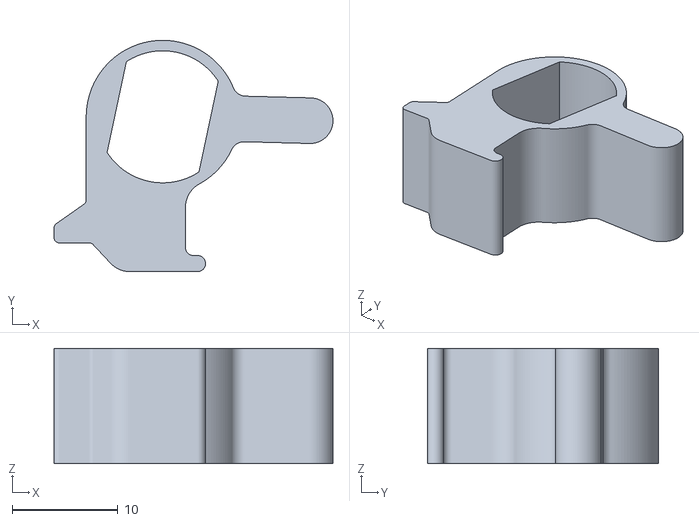
[picture p61: CAD file, 2021-05-18]
Group A/Release Internal.STL
26.4 x 21.9 x 10.9
