NortheastDesigns/Venturi-MK8/Group B/Plunger Top.STL

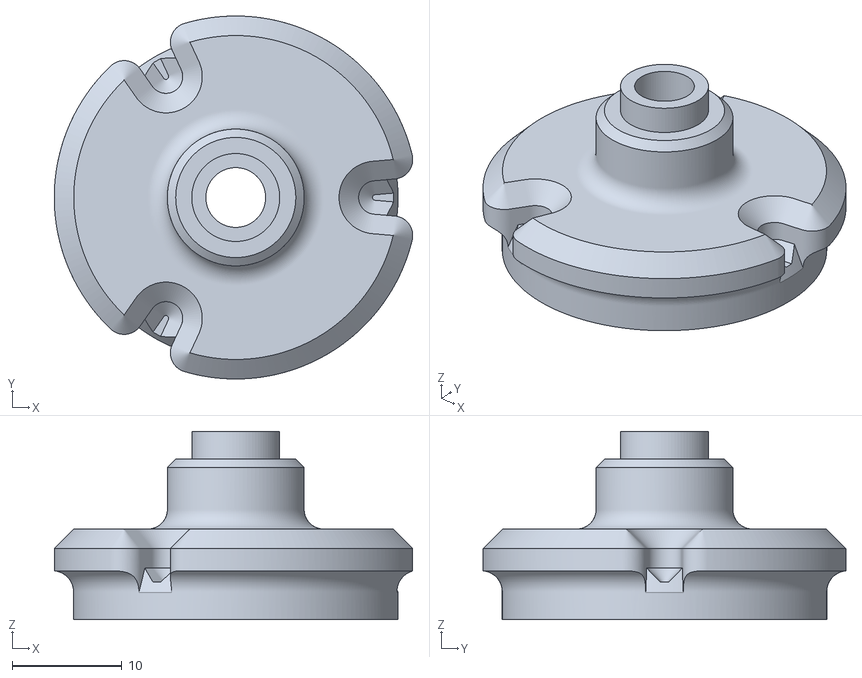
[picture p62: CAD file, 2021-04-11]
Group B/Plunger Top.STL
32.6 x 33.0 x 17.1
