NortheastDesigns/Venturi-MK8/Group E/SNOWO Plate.STL

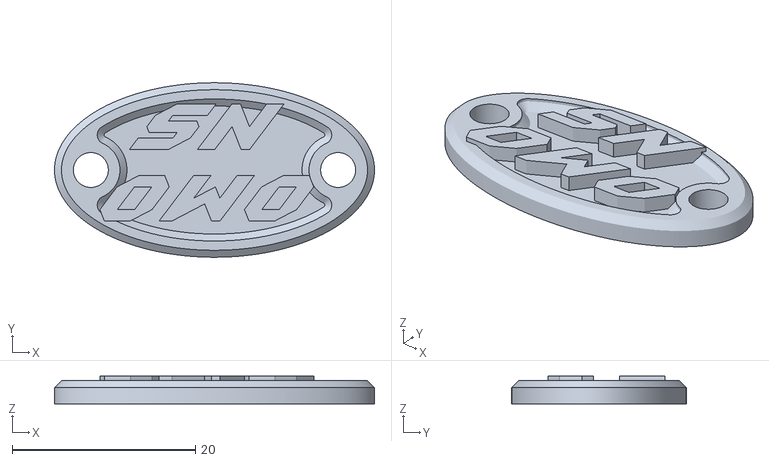
[picture p63: CAD file, 2021-04-11]
Group E/SNOWO Plate.STL
34.9 x 19.0 x 3.01
