NortheastDesigns/Venturi-MK8/Group A/PT Mount.STL

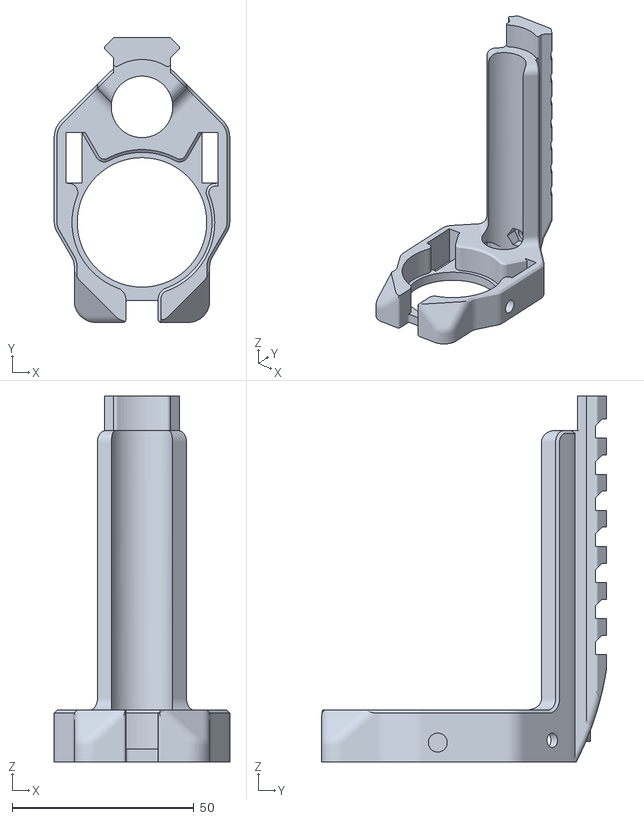
[picture p64: CAD file, 2021-05-18]
Group A/PT Mount.STL
48.3 x 78.3 x 100.6
