NortheastDesigns/Venturi-MK8/Group A/Catch House.STL

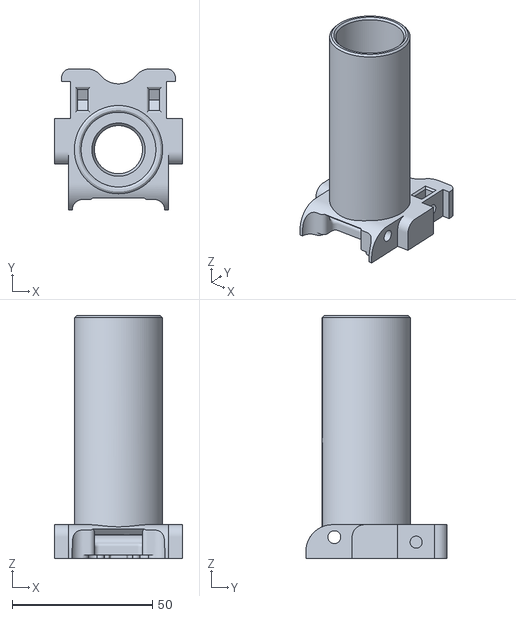
[picture p65: CAD file, 2021-04-24]
Group A/Catch House.STL
45.7 x 50.4 x 86.7
