NortheastDesigns/Venturi-MK8/Extras and Experimental/SHORT PIN Muzzle.STL

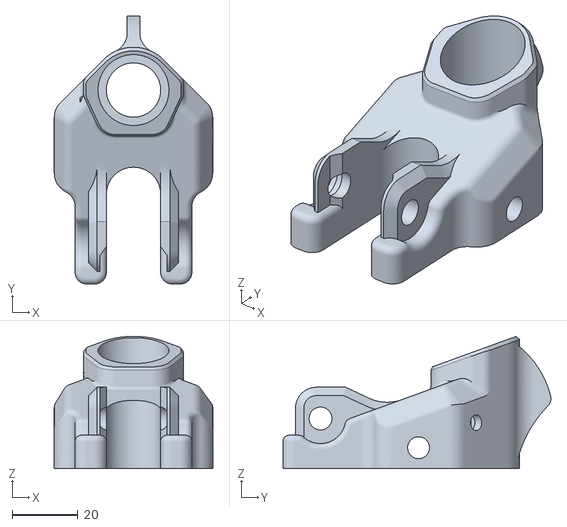
[picture p66: CAD file, 2021-04-11]
Extras and Experimental/SHORT PIN Muzzle.STL
48.3 x 81.6 x 40.2
