NortheastDesigns/Venturi-MK8/Extras and Experimental/SlamTrigger.STL

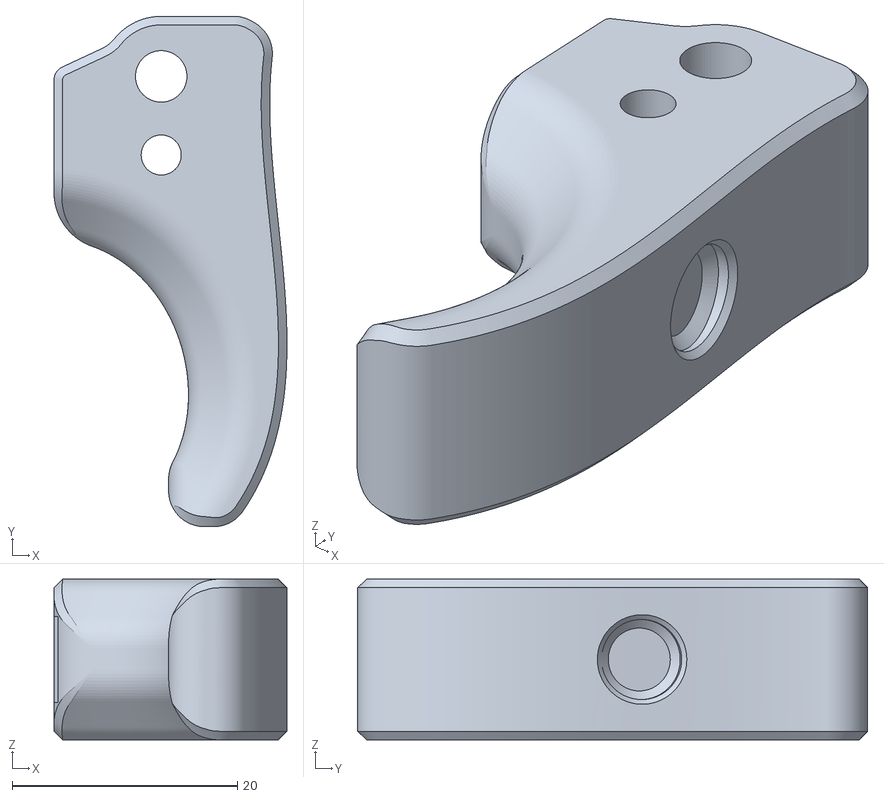
[picture p67: CAD file, 2021-04-11]
Extras and Experimental/SlamTrigger.STL
20.7 x 45.3 x 14.3
