NortheastDesigns/Venturi-MK8/Extras and Experimental/SlamActuator.STL

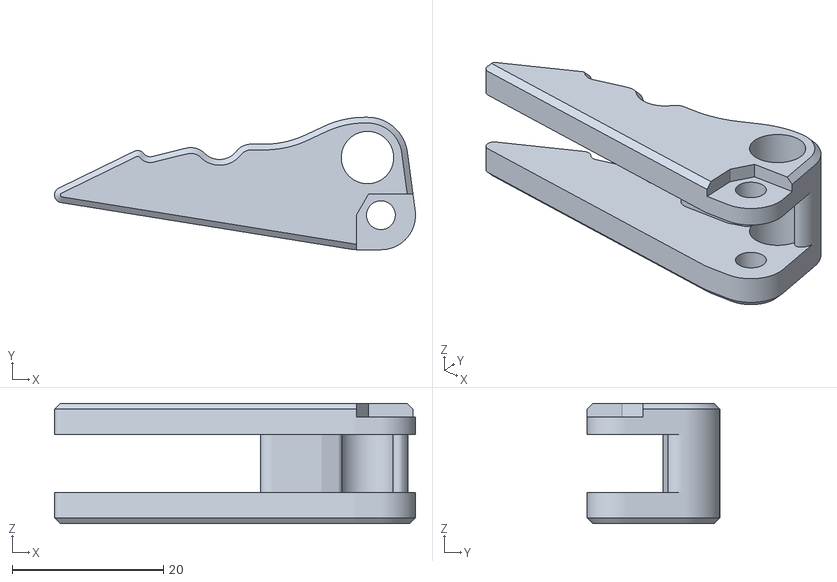
[picture p68: CAD file, 2021-04-11]
Extras and Experimental/SlamActuator.STL
47.7 x 17.5 x 15.9
