NortheastDesigns/Venturi-MK8/(list of files, cad)

Other CAD files:
Group D/ST Handle Left.STL
NO INSERTS/NO INSERTS ST Handle Right.STL
Slimnose/Alternate Actuators/Slimnose Actuator +.05.STL
Group D/AT Handle Left.STL
Slim AT Handle/NO BOTTOM SHIM SLIM AT Handle Right.STL
Group C/Alternate Actuators/Actuator +.025.STL
Group D/AT Handle Right.STL
NO INSERTS/NO INSERTS AT Handle Left.STL
Slim AT Handle/SLIM AT Handle Left.STL
Group C/Alternate Actuators/Actuator +.05.STL
Group B/AT T Gaurd.STL
Group B/Plunger.STL
NO INSERTS/NO INSERTS ST T Gaurd.STL
NO INSERTS/NO INSERTS Release External.STL
Group E/SN69 Plate.STL
Group E/SNDIY Plate.STL
Extras and Experimental/OLD L Slide.STL
Extras and Experimental/OLD R Slide.STL
Extras and Experimental/PT Mount OLD.STL
Group C/Alternate Actuators/Actuator -.0125.STL
Group C/Alternate Actuators/Actuator -.025.STL
Group C/Alternate Actuators/Actuator -.0375.STL
Group E/M3 Panel Washer.STL
Group E/M4 Panel Washer.STL
Group E/M4 Thumbscrew.STL
Group E/M5 Thumbscrew BUTTON HEAD.STL
Group E/M5 Thumbscrew HEX HEAD.STL
Group E/Muzzle Nut Shim.STL
Slimnose/Alternate Actuators/Slimnose Actuator -.025.STL
Slimnose/Alternate Actuators/Slimnose Actuator -.05.STL
Slimnose/OLD TURNAROUND Slimnose PT Mount.STL
