NortheastDesigns/Venturi-MK8/Handling Guide.pdf

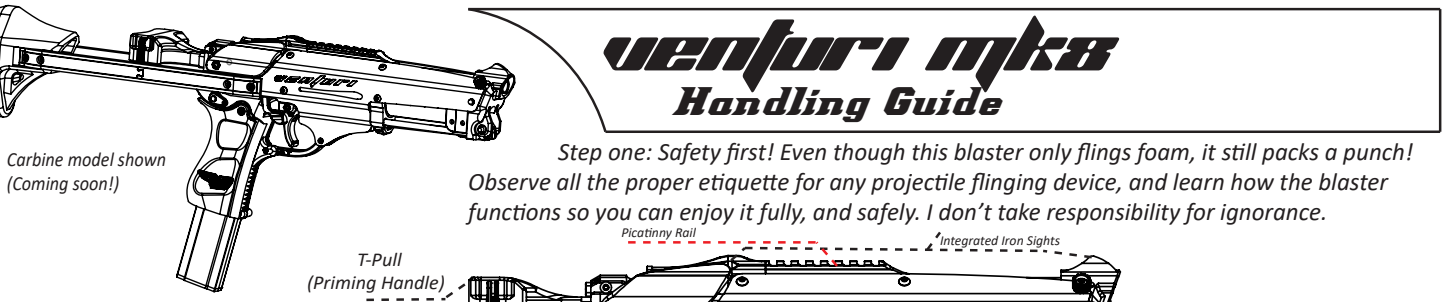
[picture p69: figure]
vENTURI MK8 Handling Guide; T-Pull (Priming Handle); Integrated Iron Sights Picatinny Rail; Carbine model shown (Coming soon!)

Step one: Safety first! Even though this blaster only flings foam, it still packs a punch! Observe all the proper etiquette for any projectile flinging device, and learn how the blaster functions so you can enjoy it fully, and safely. I don’t take responsibility for ignorance.

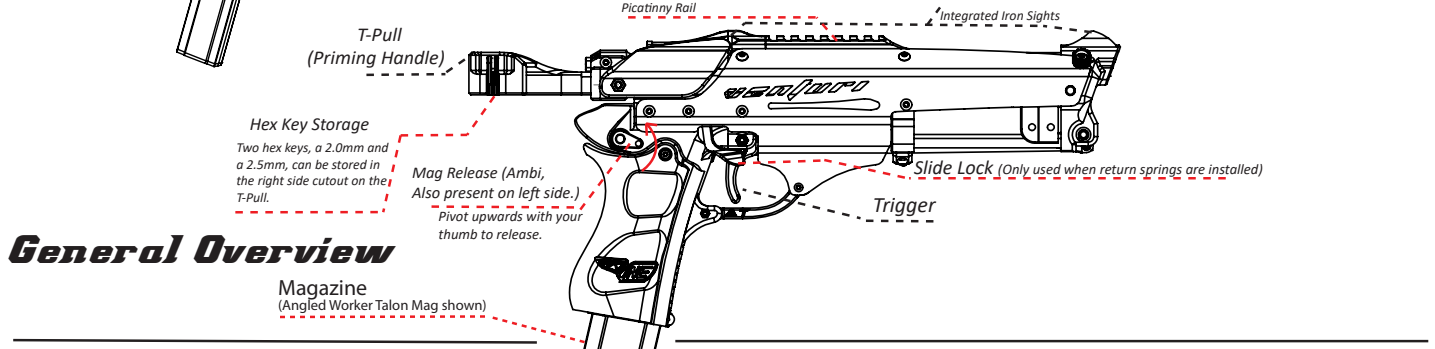
[picture p70: figure]
Trigger; Mag Release (Ambi, Also present on left side.) Pivot upwards with your thumb to release.; Hex Key Storage; Two hex keys, a 2.0mm and a 2.5mm, can be stored in the right side cutout on the T-Pull.; Magazine (Angled Worker Talon Mag shown); General Overview

Slide Lock (Only used when return springs are installed)

## Firing Guide:

1: Load darts into your magazine and install it in the bottom of the grip, feeding it until it clicks into place. This blaster has a “Van’s Gourd” style pusher cutout, allowing you to install mags easily on a closed bolt.

2: Firmly grasp the T Pull as shown (while holding the handle with your dominant hand), and pull back
to prime the blaster, pulling until the catch engages. (Draw length: ~2.8 Inches.)

It is possible to de-prime this blaster safely, even with a dart in the chamber.

To de-prime the Venturi, simply block the barrel with your palm and pull the trigger. If there’s a dart in the chamber, release your palm quickly right as you pull the trigger, which should eject the dart at ~5-10 FPS.

## Upgrades (Coming Soon!)

2.875” Max
Draw Length
(.0875” Stock
Overdraw)

3: Once primed, push the T pull back to feed a dart into the turnaround, until the pusher seats and seals in the forward position.

4: Pull the trigger firmly, releasing the catch and firing the dart. You can build a feel for the force needed to release your catch to more accurately time your shots. Regular maintenance helps maintain proper trigger feel.

## WARNING: Finger danger zone! :0 Keep ngers clear while priming!

# De-priming:

Venturi Do’s (:3) And Dont’s (>:C)
Do’s (:3) | Dont’s (>:C)
-Regularly clean &
maintain
-Prime the action
swiftly, but smoothly.
-Use high quality
darts (IE: AFP)
-Lubricate regularly
with good stuff like
Oatey’s Silicone
Grease.

-Under lube the
mech
-Store the blaster
primed / leave it
primed too long.
-Pull the trigger /
Hold the trigger
while priming.

# WARNING!

## This blaster does NOT have slam fire! (Yet~)

Do not press or hold the trigger while priming,

## if you do the actuator will collide with the

Catch House, causing the action to seat incorrectly.

-Slide Lock & Slide Return Springs

-Picatinny Pump Grip
Attachment Boss

-Carbine Frame Stock
