NortheastDesigns/Venturi-MK8/Takedown Guide.pdf

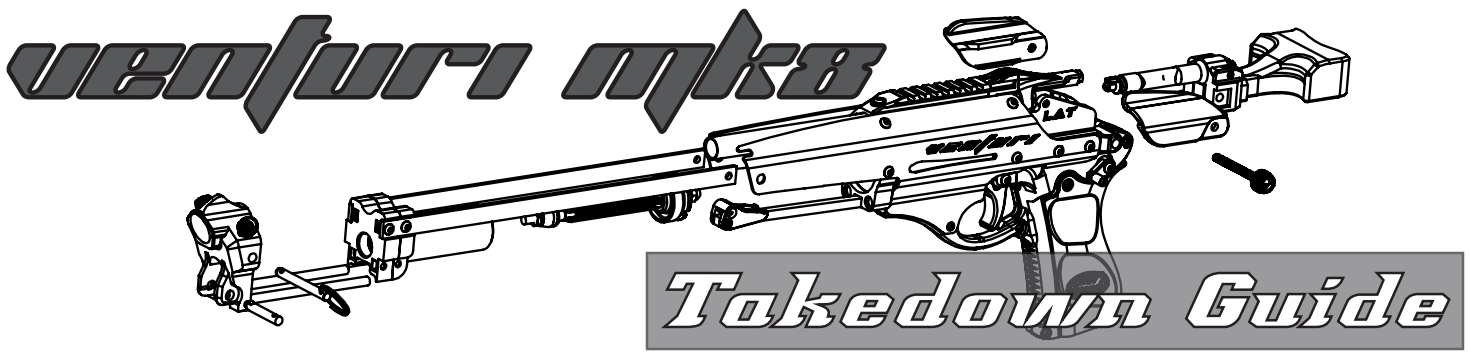
[picture p72: figure]
Venturi mk8; Takedown Guide

Step Zero: Safety first! Do not attempt to dissasembly this blaster until you’ve learned howit works
and how to properly operate / service it. If you install a spring with a large amount of preload, the catch house fly off during takedown.

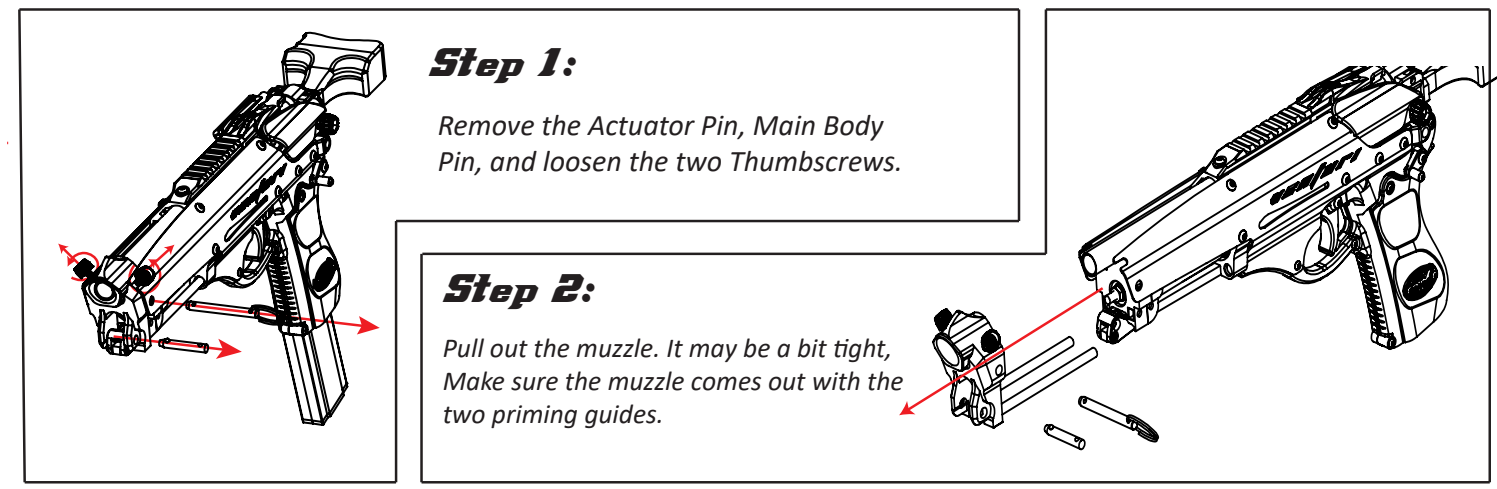
[picture p73: figure]
Step 2:; Step 1:; Remove the Actuator Pin, Main Body Pin, and loosen the two Thumbscrews.; Make sure the muzzle comes out with the two priming guides.
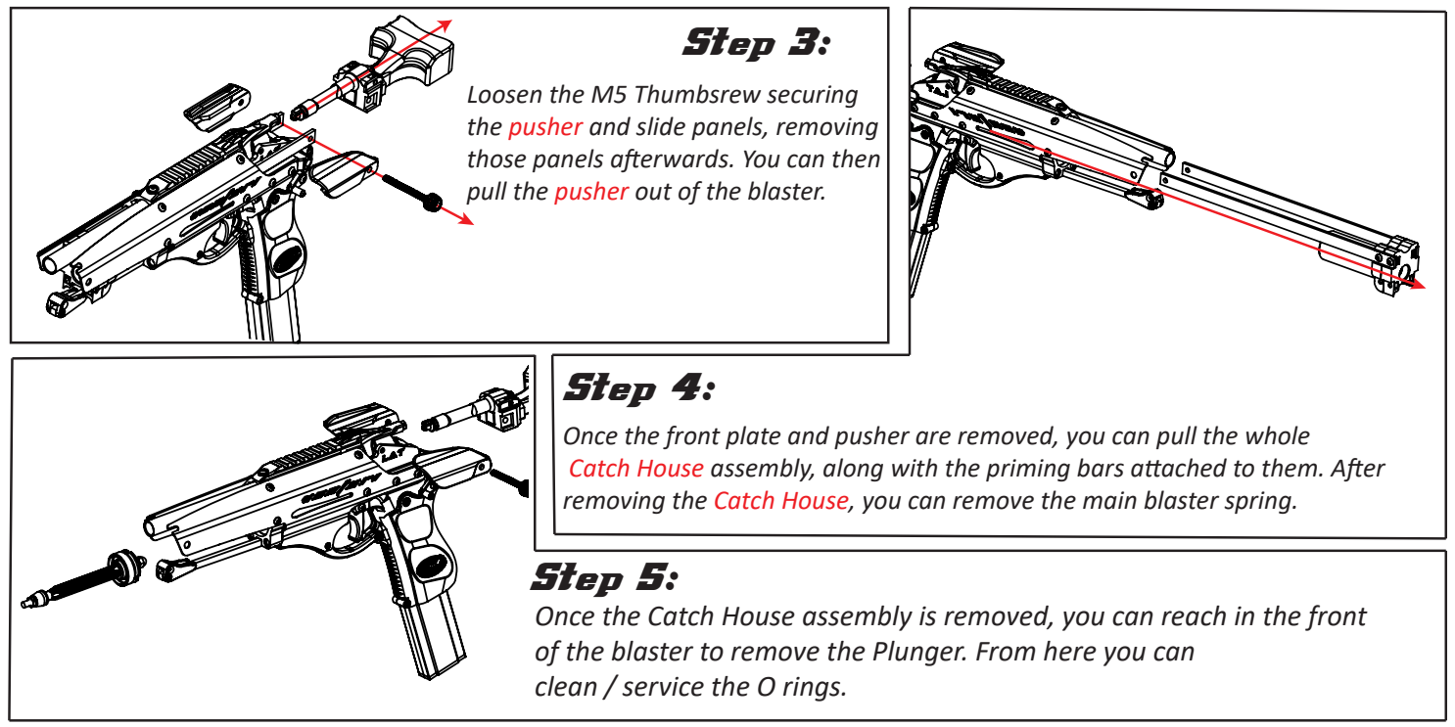
[picture p74: figure]
Step 3:; Loosen the M5 Thumbsrew securing the pusher and slide panels, removing those panels afterwards. You can then pull the pusher out of the blaster.; Step 4:; clean / service the O rings.; Step 5:

This work is licensed under the Creative Commons Attribution-NonCommercial 4.0 International License. To view a copy of this license, visit http://creativecommons.org/licenses/by-nc/4.0/

# Northeast Designs

Pull out the muzzle. It may be a bit tight,

Once the front plate and pusher are removed, you can pull the whole Catch House assembly, along with the priming bars attached to them. After removing the Catch House, you can remove the main blaster spring.

Once the Catch House assembly is removed, you can reach in the front of the blaster to remove the Plunger. From here you can
