NortheastDesigns/Venturi-MK8/Carbine/Carbine Print Orientations.PNG

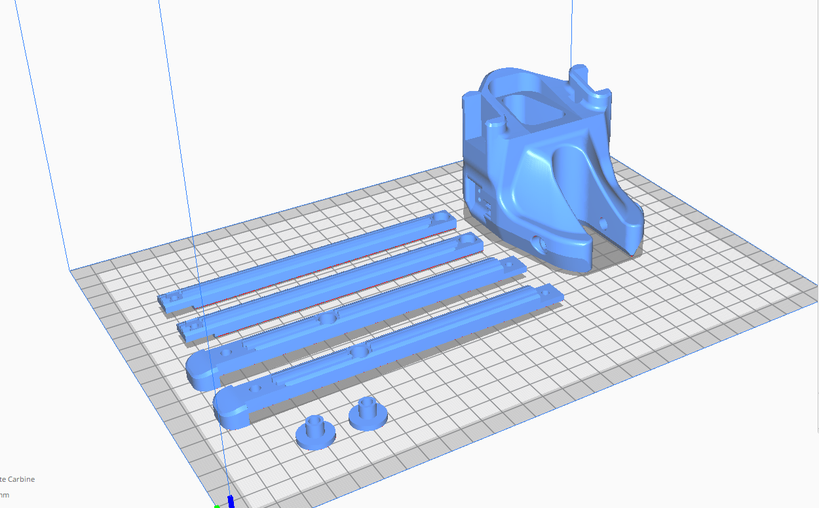
Carbine/Carbine Print Orientations.PNG
