NortheastDesigns/Venturi-MK8/Carbine/Pump Mount Print Orientation.PNG

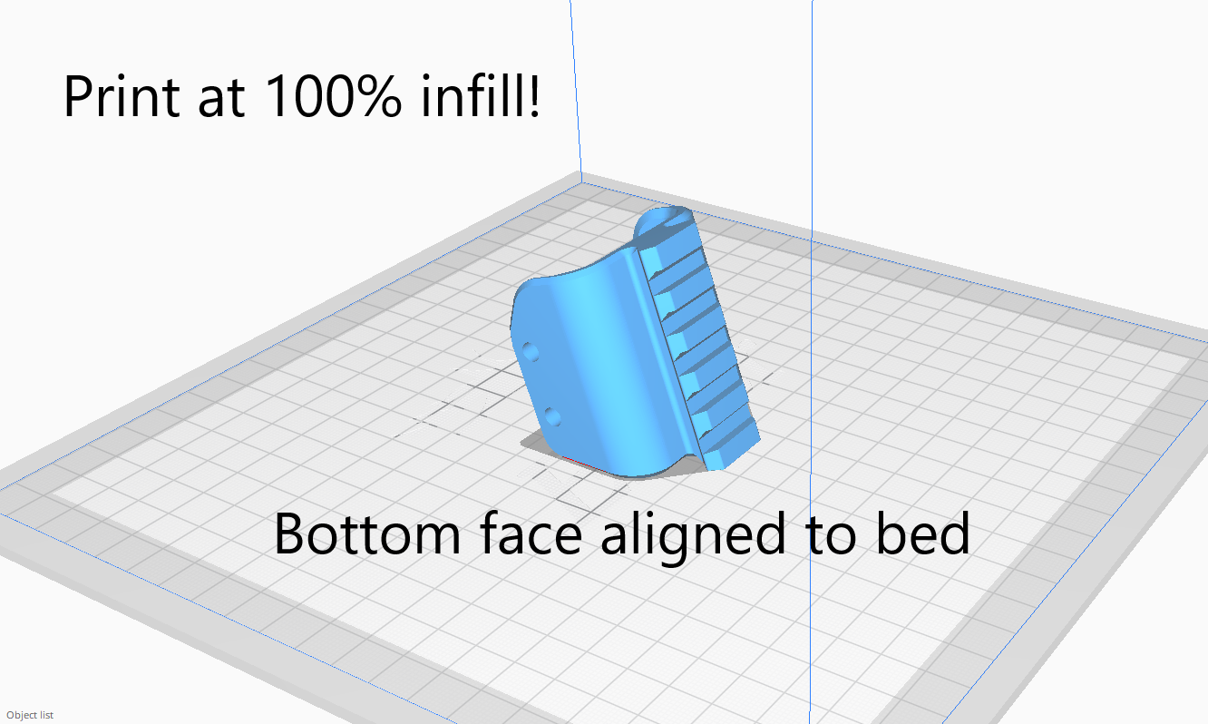
Carbine/Pump Mount Print Orientation.PNG
