NortheastDesigns/Venturi-MK8/Slim AT Handle/SLIM AT Print Orientations.png

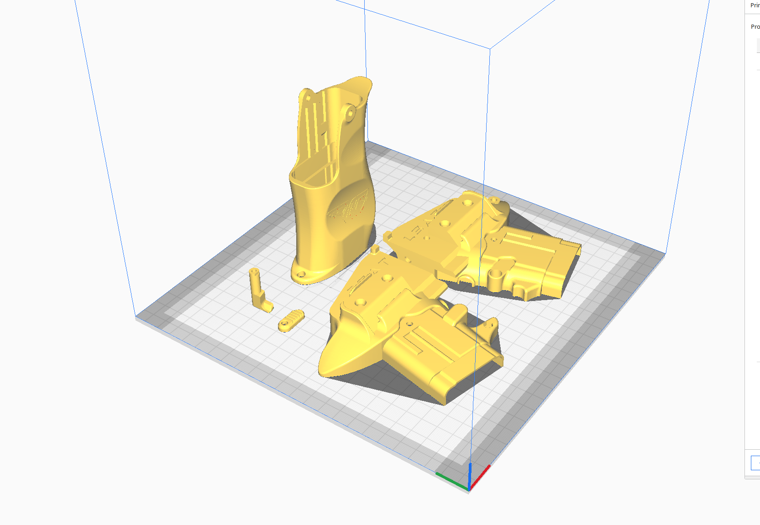
Slim AT Handle/SLIM AT Print Orientations.png
