NortheastDesigns/Venturi-MK8/Slimnose/SlimNose Print Orientations .png

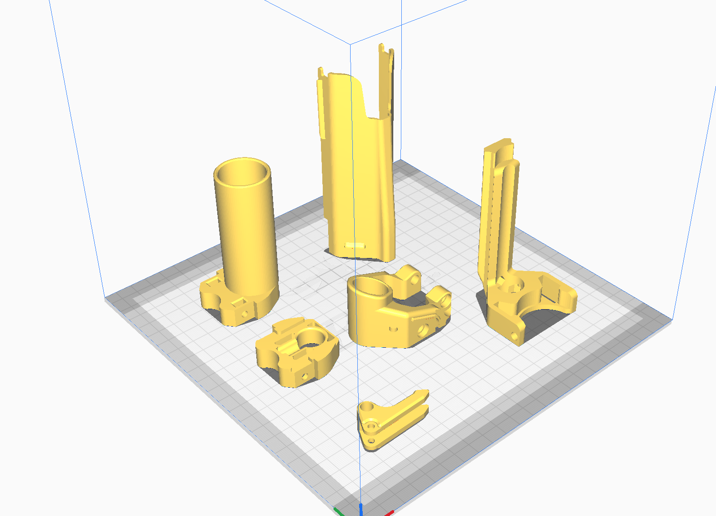
Slimnose/SlimNose Print Orientations .png
