NortheastDesigns/Venturi-MK8/(commit log)

2021-04-11 Add files via upload
    Frame kit link fixed
2021-04-13 No inserts pusher & Handling guide added
    [NO INSERTS Pusher.STL]
2021-04-18 Add files via upload
    ST Handle halves updated, fixed fitment with monogrip and strengthened.
    [ST Handle Left.STL, ST Handle Right.STL]
2021-04-18 Add files via upload
    Correct R slide file updated, L slide changed slightly to prevent possible nozzle snag.
    [L Slide.STL, R Slide.STL]
